torsteml/TFE4152-Project/report/TFE4152_project.pdf

Norges teknisk-naturvitenskapelige

universitet

TFE4152

# Design av 4 piksels digitalkamera

Skrevet av:
Markus Rud
Torstein Langan
20. november 2018

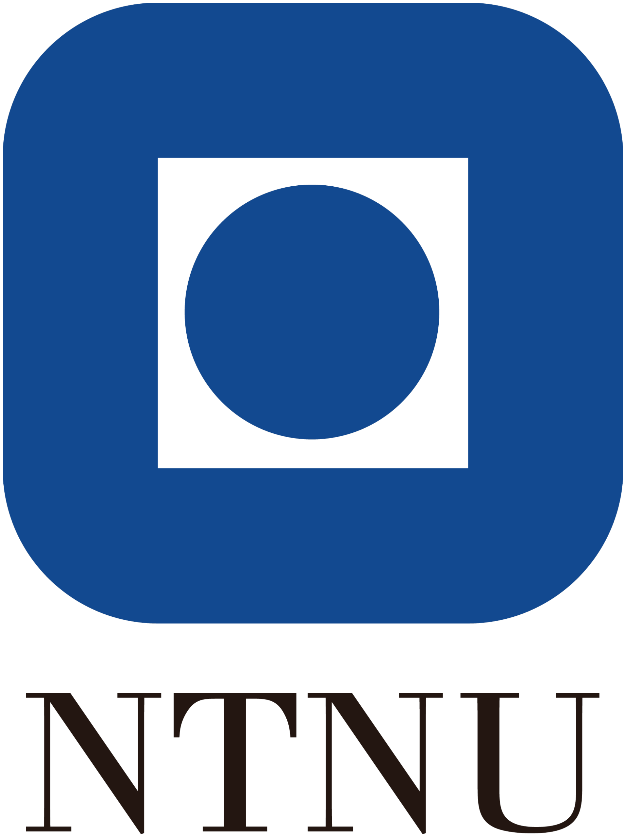
[picture p1: figure]

Sammendrag

En forenklet modell av et digitalkamera bestående av 4 piksler med tilhørende digital logikk og analog krets er blitt designet. Active-HDL og AIM-spice ble brukt til modellering, simulering og test for henholdsvis den digitale og analoge delen av systemet og ledet til en detaljert simulering av kritiske deler i et primitivt digitalkamera. Hver piksel ble bygget opp av NMOS og PMOS transistorer, som alle fungerte enten som brytere, aktive laster eller forsterkere, i tillegg til en fotodiode som registrerte pikselens påførte lysmengde under en gitt eksponeringstid. I tillegg ble det konstruert digital logikk for presis kontroll av pikslene. To tilstandsmaskiner og ett skiftregister holdt orden på eksponeringstid og sendte ut korrekte styringssignal til transistorbryterne i den analoge kretsen. Systemet oppfylte alle krav ved testing.

i

## Innhold

1 Introduksjon | 1
2 Teori | 1
3 Design | 10
4 Simulering og test | 15
5 Resultat og diskusjon | 19
6 Konklusjon | 22
Bibliografi | 23
A Digital kontrollogikk | 24

ii

B Analog krets | 30

iii

## 1 Introduksjon

Etter at digitalkameraet ble oppfunnet på tidlig 1970-tall har det revolusjonert hvordan vi mennesker deler informasjon med hverandre. Vi kunne ta mangfoldige tusen bilder om dagen, og dokumentere våre liv på ett detaljnivå vi tidligere ikke turte drømme om, samtidig som vi har enda finere kontroll over kamerainnstillingene enn før ved hjelp av microchiper og registre som styrer alle parametere med en utrolig nøyaktighet og presisjon. Som en del av kurset Design av integrerte kretser skal vi i dette notatet beskrive et mulig design for en primitiv version av et 4 piksels digitalkamera. Dette for å bedre forstå virkemåte og designhensyn som inngår i en slik prosess.

Det er designet en krets for et 4-piksels digtalkamera med mulighet for at brukeren kan justere eksponeringstiden ved påført signal på inngangene Exp increase og Exp decrease som vist i figur 1.1, før et bilde kan taes ved å påføre et signal på inngangen Init. Design av analog til digitalkonverteren ADC er ikke inkludert i dette notatet. Systemets utganger Out1 og Out2 settes til en digital verdi avhengig av mengden lys som treffer pikslene i den analoge kretsen.

Figur 1.1: Blokksjema av tenkt realisering.

## 2 Teori

Som vist i figur 1.1 er systemet bygget opp av tre mindre delsystemer der den digitale kontrollogikken og den analoge kretsen er presentert i denne rapporten. Da disse er designet svært individuelt vil resten av rapporten også behandle disse i stor grad adskilt.

### 2.1 Digital kontrollogikk

Første delsystem i kameraet er den digitale kontrollogikken. Et blokkskjema er vist i figur 2.1 og viser systemets inn og utganger. Systemet tar inn signalene Exp increase, Exp decrease og Init fra brukeren av kameraet mens reset-signalet Reset og klokka Clk kommer fra ytterligere kontrollogikk. Systemets 5 utganger kontrollerer ulike deler av den analoge kretsen hvor NRE R1 og NRE R2 kontrollerer når og hvilken piksel som skal avleses, ADC kontrollerer når ADCen skal initialiseres, Expose kontrollerer når kretsen skal eksponeres for lys og Erase nullstiller den analoge kretsen.

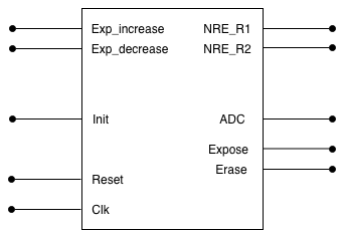
[picture p2: figure]

Figur 2.1: Blokkskjema av digitalt system for styring av analog krets.

Det digitale systemet er videre delt opp i tre mindre delsystemer som vist i figur 2.2. Av figuren kan man se at de nevnte delsystemene er CT RL ex time, T imer counter og F SM ex control. Disse er henholdsvis et register for eksponeringstid, en nedteller og FSM kontroll. Hver av disse vil bli forklart i påfølgende delkapitler.

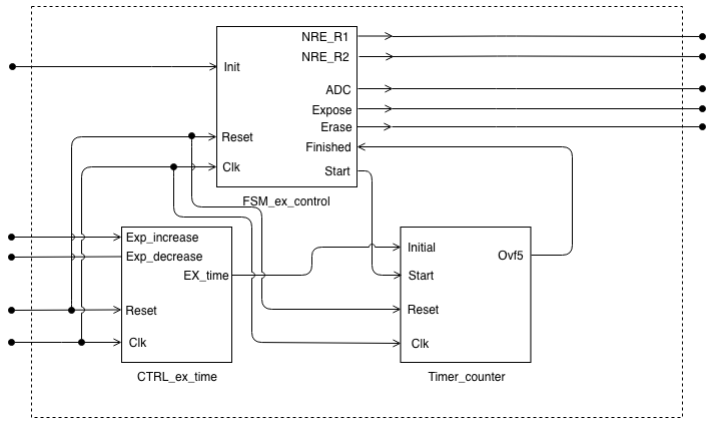
[picture p3: figure]

Figur 2.2: Blokkskjema for de ulike delsystemene i den digitale kontrollogikken.

### 2.1.1 Eksponeringstidregister

Når brukeren ønsker å ta et bilde er det nødvendig å vite hvor lenge pikslene skal eksponeres for lys da dette har mye å si for bildets kvalitet. Denne tiden kalles eksponeringstiden og ligger lagret i eksponeringstidregisteret. Systemet CT RL ex time på figur 2.2 er systemet som skriver tiden til registeret samt har nødvendig logikk for enten å øke eller senke eksponeringstiden. Dette kan gjøre på flere måter, men er her implementert ved bruk av et enkelt flerbits skiftregister som kan inkrementeres eller dekrementes ved bruk av signalene Exp increment og Exp decrement. Signalene er aktive høye, altså ved påtrykt Vdd. Ved høyt påtrykk på Exp increase skal systemet øke eksponeringstiden, mens ved høyt påtrykk på Exp decrease skal eksponeringstiden minke. Ved påtrykk på begge signalene samtidig er Exp increase satt til å ha prioritet.

### 2.1.2 Nedteller

Nedtelleren, T imer counter på figur 2.2, har som oppgave å telle ned eksponeringstiden avlest fra eksoponeringstidregisteret. Systemet skal starte nedtellingen ved høy verdi på Start og ved ferdig nedtelling settes utgangssignalet Ovf5 til høy verdi i en klokkesykel. Dette delsystemet er implementert som en tilstandsmaskin hvor tilstanden settes avhengig av delsystemene rundt. Nærmere design av denne er forklart i kapittel 3.1.2.

### 2.1.3 FSM kontroll

FSM kontroll, F SM ex control på figur 2.2, er kontrollenheten til hele systemet vist i blokkskjemaet i figur 1.1. FSM kontrollen mottar signalet Init fra brukeren og starter så en bildesekvens. Start-signalet starter telleren i T imer counter. Systemet er implementert som en tilstandsmaskin hvor tilstandene endres avhengig av input fra brukeren og T imer counter. Design av tilstandsmaskinen samt oversikt over ulike utgangssignaler i tilstandene er nærmere forklart i kapittel 3.1.3.

### 2.2 Analog pikselkrets

Den analog kretsen har som oppgave å detektere hvor mye lys som treffer et rutenett av piksler i løpet av en gitt eksponeringstid. Et slikt rutenettet kan bygges opp ved å sette flere enkeltpiksler sammen til en større krets slik at de individuelle pikselkretsene sammen kan danne et bilde.

### 2.2.1 Enkeltpiksel

Figur 2.3 viser hvordan en enkelt piksel kan bygges opp ved bruk av en fotodiode P D1 og flere MOSFET transistorer. På figuren er Vdd forsyningsspenningen og Vss er jordingsspenningen.

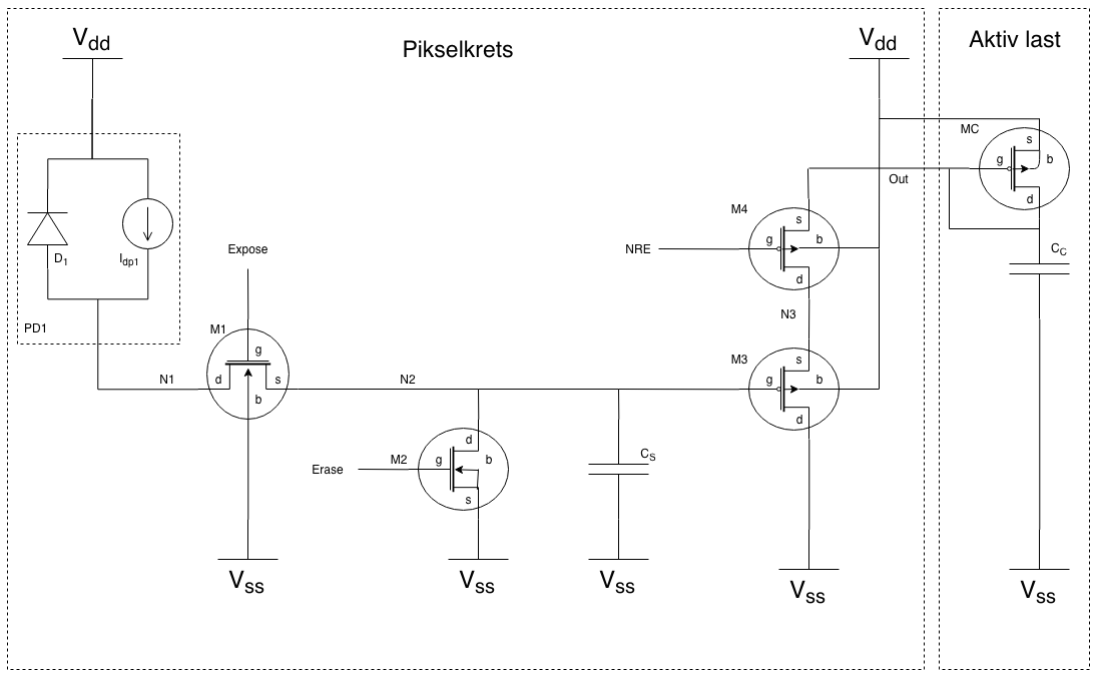
[picture p4: figure]

Figur 2.3: Analog krets for én piksel.

Fotodioden P D1 er her representert ved strømkilden Idp1 og pn-dioden D1 som vist i figuren. Ved lysinnstråling på P D1 øker den sin strømførende evne og det genereres en strøm til node N1. Når Expose-signalet settes høyt vil denne strømmen fortsette til node N2 gjennom transistoren M1 og dermed lade opp spenningen i kondensator CS. Når eksponeringen av bildet er ferdig settes Expose-signalet lavt og M1 lukkes. Den oppladede spenningen i CS forsterkes så gjennom transistoren M3 og blir tilgjengelig på utgangen Out når signalet NRE går lavt og åpner transistor M4. Når spenningen er avlest lukkes M4 og M2 åpnes ved å påføre spenning på Erase, dette setter spenningen på node N2 til Vss og kretsen er klar til å ta et nytt bilde.

Av figuren kan man også se det er en aktiv last bestående av transistoren MC og kondensatoren CC koblet til kretsen. Sammen med transistoren M3 skaper dette en buffer som holder spenningen på Out konstant lik spenningen over CS selv om verdien leses av.

### 2.2.2 Presentasjon av relevante transistorlikninger

Den analoge kretsens virkemåte er forklart i kapittel 2.2.1, men en annen viktig faktor for å oppnå riktig oppførsel er transistorenes størrelse. Transistorene i figur 2.3 har forskjellige virkemåter hvor transistorene M1, M2 og M4 benyttes som brytere, M3 benyttes som forsterker og MC benyttes som en aktiv last. Dimensjonene til de ulike transistorene avhenger av funksjonen og likninger for dette presenteres i senere delkapitler. Først i dette delkapitlet presenteres generelle transistorformler som videre brukes i mer spesifikke likninger og beregninger. Likningene som presenteres gjelder for NMOS-transistorer, men ved å invertere alle spenningene over transistorene kan samme likninger benyttes for NMOS-transistorer.

Generelle likninger for MOS transistorer
For en generell MOS transistor kan effektiv gate-source spenning uttrykkes på følgende måte [1, (1.50)]:

Vef f = Vgs − Vt

. | (2.1)

Transistorens terskelspenning Vt inkludert body effekt kan uttrykkes ved [1, (1.69)]:

Vt = Vt0 + γ(

p
VSB + |2φF | − p
|2φF |) | (2.2)

der γ er gitt av (2.10). Body effekt oppstår når source og body har forskjellig potensial, altså VSB 6= 0, og gjør at det blir vanskeligere for elektronene å bevege seg over pn-overgangen mellom drain og source. Denne effekten kan modelleres som en økt terskelspenning Vt som i (2.2). Vt0 er terskelspenningen ved null source-bulk spenning.

Bodyens Fermipotensial er gitt av følgende likning[1, s. 25]:

ΦF =

kT
q

ln NA
ni
| (2.3)

hvor k er Boltzmanns konstant, q er elementærladningen, NA er konsentrasjonen av mottaksatomer i silisium, ni er carrier konsentrasjonen til silisium og T er den absolutte temperaturen. Til slutt gir[1, (1.52)]

Cox =

Kox0

tox

(2.4)

gate kapasitansen (Cox), der Kox er den relative permittiviteten til silisium, 0 er permittiviteten til vakum og tox er tykkelsen på oksiden under gaten.

Likninger for MOS transistorer i aktivt område
For en MOSFET transistor i aktivt område uttrykkes drainstrømmen ID med følgende formel [1, (1.67)]:

ID =

µCox
2

W
L

(VGS − Vt)

2
[1 + λ(VDS − (VGS − Vt))] | (2.5)

der VGS er potensialforskjellen mellom gate og source, VDS er potensialforskjellen mellom drain og source og Vt er terskelspenningen til transistoren. W og L er hhv. bredde og lengde til transistoren og µ er mobiliteten til elektronene nære silikonoverflaten. λ er channel-length modulasjonsparameteren gitt av følgende likning [1, (1.87)]:

λ =

1
L

p
VDS − Vef f + Φ0
. | (2.6)

Short channel effekt er en bivirkning som oppstår når kanalen på undersiden av MOS-FETen blir mye tynnere enn utarmingssonen til drain og source. Det oppstår også short channel effekter ved VDS >> Vef f , og det er derfor viktig å begrense VDS for å minimere denne effekten. Φ0 er den innebygde spenningen til pn-overgangen i transistoren.

Videre er sammenhengen mellom motstanden fra drain til source og ID gitt av [1, (1.86)]

rds ≈

1
λID
. | (2.7)

Transkonduktansen til en MOSFET gitt ved [1, (1.77)]

gm =

r
2µCox

W
L
ID | (2.8)

mens den separate transkonduktansen til body effekten er [1, (1.83)]

gmb =

γgm
2

p
VSB + |2ΦF |

(2.9)

der γ kan uttrykkes ved [1, (1.70)]

γ =

√
2qNAKS0

Cox

. | (2.10)

Ks er her den relative permittiviteten til silisium. Legg merke til at selv om VSB = 0 i formel 2.9 ikke matematisk gir gmb = 0, vil en direkte kobling mellom bulk og source gjøre at body effekt transkonduktansen ekskluderes.

Likninger for en MOSFET i subterskel tilstand
Når VGS < Vt befinner transistoren seg i subterskel tilstand og spesielle tilfeller gjelder. Drainstrømmen uttrykkes ved [1, (1.121)]

ID = ID0

W
L

e

qVeff /nkT | (2.11)

som viser at ID ikke er null selv om VGS < Vt

. Videre kan n uttrykkes ved [1, (1.119)]

n =

Cox + Cj0

Cox

(2.12)

og drainstrømkonstanten, ID0, uttrykkes ved [1, (1.120)]

ID0 = (n − 1)µCox(

kT
q

)

2
. | (2.13)

### 2.2.3 Kondensatorstørrelser

Som nevnt i delkapittel 2.2.1 lades kondensatoren CS opp så lenge Expose har et høyt påtrykk. For at spenningen i kondensatoren skal være forutsigbar uavhengig av eksponeringstiden eller lysstyrken er det ønskelig at oppladningen av kondensatoren er lineær. Dette er mulig å oppnå ved å tilpasse kondensatorstørrelsen slik at den unngår metning. Spenningen over en kondensator er gitt ved

V =

1
C

Z T

0

i(t)dt | (2.14)

hvor V er spenningen over kondensatoren, C er kondensatorverdien, i(t) er strømmen gjennom kondensatoren og T er tiden kondensatoren blir ladet opp.

Ved beregning av størrelsen til kondensator CS er spenningen V gitt av spenningenspotensialet VN2 i node N2. Dette potensialet kan beregnes ut fra (2.1) med

Vgs = Vg − Vs = Vg − VN2 | (2.15)

hvor Vg er satt til Vdd ved høy påkjenning på Expose. Det er ønskelig at transistor M1 alltid opererer i sterk inversjon og av den grunn må Vef f være større enn 100mV[1,
s. 22]. Vt er gitt av (2.2) som også tar hensyn til transistorens body-effekt. Størrelsen på kondensator CC i den aktive lasten er gitt av spesifikasjonene.

### 2.2.4 Brytere

For at en transistor skal være i aktivt område må følgende betingelser oppfylles:

VGS > Vt | (2.16)
VDS > VGS − Vt | (2.17)

Det observeres at dette er tilfellet når både M1, M2 og M4 opereres, og dermed kan formel 2.5 og 2.7 benyttes.

Ved design av MOSFET-brytere er det to motstående fokusområder, spenningsfall over MOSFETen og hastigheten bryteren kan lukkes med. For transistor M1 og M4 er ikke hastigheten prioritert på grunn av systemets lave klokkefrekvens, men det ønskes heller et lavt spenningsfall for å minimere spenningsforskjellen mellom dioden P D1 og oppladningsspenningen til kondensatoren Cs. Fra formel 2.5 og 2.7 kan man se at motstanden rds får lavest verdi ved en høy strøm ID og det settes dermed en stor bredde W og en liten lengde L for at transistorene M1 og M4 skal ha en lav motstand rds og dermed lavt spenningsfall fra drain til source. Transistor M2 er koblet mellom node N2 og jordingsspenningen Vss og vil derfor utlade kondensator Cs om ikke lekasjestrømmen når transistoren er lukket er tilstrekkelig liten. Av formel 2.13 observeres det at for en liten ID, når transistoren er lukket, trengs en lav bredde W og stor lengde L.

Ved en lukket transistor M2 vil det likevel oppstå en liten lekasjestrøm til tross for at transistoren har blitt optimalisert med tanke på akkurat dette. For en lukket transistor gjelder Vgs < Vt og fra likningene 2.11, 2.12 og 2.13 kan lekasjestrømmen beregnes.

### 2.2.5 Source-følger

For at Cs ikke skal lades ut i det øyeblikket verdien utleses på utgangen, er det nødvendig med en buffer med så stor inngangsmotstand mellom Cs og utgangen som mulig. Bufferen kan realiseres som en source-følger med forsterkning tilnærmet lik 1, og transistorene M3 og MC tilpasses slik at bufferen oppfyller kravene. Kretsen i figur 2.3 forenkles ved å kortslutte alle bryterene, og det antas at spenningsfallet over disse er tilnærmet lik 0. I figuren nedenfor representerer Vin spenningen over kondensatoren Cs fra figur 2.3.

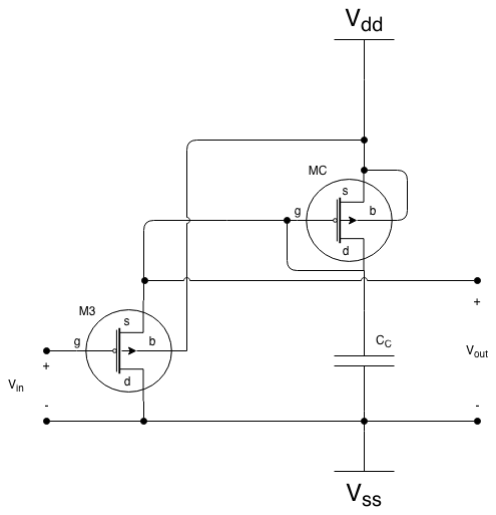
[picture p5: figure]

Figur 2.4: Transistor M3 og MC med kortsluttet transistor M4.

En småsignalekvivalent til transistor M3 er vist i figur 2.5. Vsg er spenningen mellom source og gate, Vsb er spenningen mellom source og bulk. rds3 er motstanden mellom drain og source og oppstår som følge av channel length modulasjon med modulasjonsparameter gitt av likning 2.6 og 2.7.

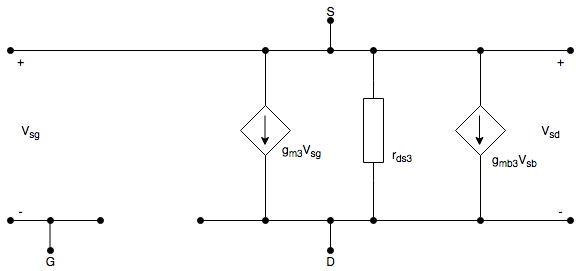
[picture p6: figure]

Figur 2.5: Småsignalekvivalent for transistoren M3.

Fordi bodyen ikke er koblet direkte til source i PMOS-transistoren M3, og det dermed oppstår en potensialforskjell mellom source og bulk (VSB 6= 0), er body effekten inkludert i utregningene. Body effekten er i figur 2.5 representert som strømkilden uttrykt ved gmb3Vsb. Ved å finne uttrykk for rds3, i tillegg til strømmene, kan det settes opp uttrykk for forholdet mellom Vout og Vin. Fra [1, (1.74)]

gm = µCox

W
L
(Vgs − Vt) | (2.18)

kan man se at transkonduktansen til transistoren er avhengig av både dimensjoner og transistorparameteren µCox i tillegg til spenningsforskjellen (Vgs − Vt).

Ulike spenningen i transistor M3 er definert som følger:

Vsg = Vout − Vin
Vsd = Vout. | (2.19)

Småsignalekvivalent til transistor MC presenteres i figur 2.6 og da bulken er koblet direkte til source er det ingen body effekt i transistoren, og derfor er det ingen potensialforskjell av formel 2.9 da VSB = 0.

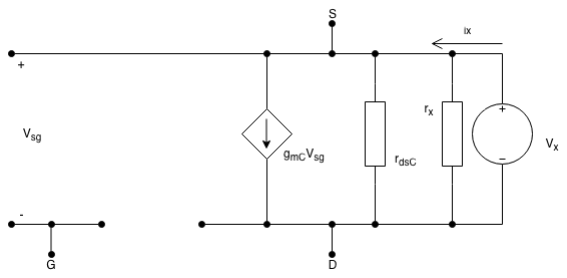
[picture p7: figure]

Figur 2.6: Småsignalekvivalent for den aktive lasten

Utgangsimpedansen til den aktive lasten er av interesse da denne er med på å definere virkemåten til source-følgeren i figur 2.4. Det påføres en testspenning Vx og en testimpedans rx på utgangen og Kirchhoff spenningslov(KVL) brukes for å definere verdien av utgangsimpedansen. Likningen

ix = gmCVsg +

Vx

rdsC

(2.20)

utledes fra KVL før det observeres at Vx = Vsg og likning 2.20 forenkles til

ix = Vx(gmC +

1

rdsC

)

Vx
ix

=

1

gmC +

1
rdsC

rx =

1

gmC +

1
rdsC
rx = RC.

(2.21)

Ved å sette sammen den aktive lasten og bufferen kan source-følgeren representeres med småsignalekvivalent som vist i figur 2.7.

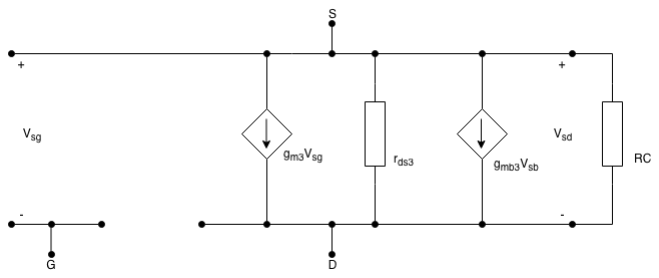
[picture p8: figure]

Figur 2.7: Småsignalekvivalent for source-følgeren med aktiv last inntegnet som impedans

Spenningsforsterkningen er gitt ved

Av =

Vout

Vin

. | (2.22)

Ved bruk av Kirchoffs strømlov og likning 2.19 settes opp likningssystemet

Vout

rds3

= gm3Vsg + gmb3Vsb +

Vout
RC

Vout

rds3

= gm3(Vout − Vin)gmb3Vout +

Vout
RC

Vout(

1

rds3

− gm3 − gmb3 −

1
RC

) = −gm3Vin.

| (2.23)

Innsatt i uttrykket for motstand RC fra likning 2.21 genereres følgende uttrykk for spenningsforsterkningen:

Av =

gm3

gm3 + gmC − gmb3 +

1
rdsC
. | (2.24)

Dette forenkles til
Av ≈

gm3

gm3 + gmC

(2.25)

når gmb3 ≈ 1/10gm3[1] og 1/rdsC ≈ 0[1] og derfor kan neglisjeres fra likning 2.24.

### 2.2.6 Rutenett av pikselkretser

For å designe en krets bestående av flere piksler er det mulig å koble sammen flere enkle pikselkretser til en større krets. En mulig oppkobling av dette er vist i figur 2.8 hvor en enkelt piksel er representert ved en boks bestående av enkeltkretsens inn og utgangssignaler. Signalene NRE R1 og NRE R2 avgjør hvilken piksel som skal leses av og signalet ADC avgjør når ADCene skal konvertere spenningen fra pikselene til en digital verdi. Resterende signaler fungerer som nevnt i delkapittel 2.2.1.

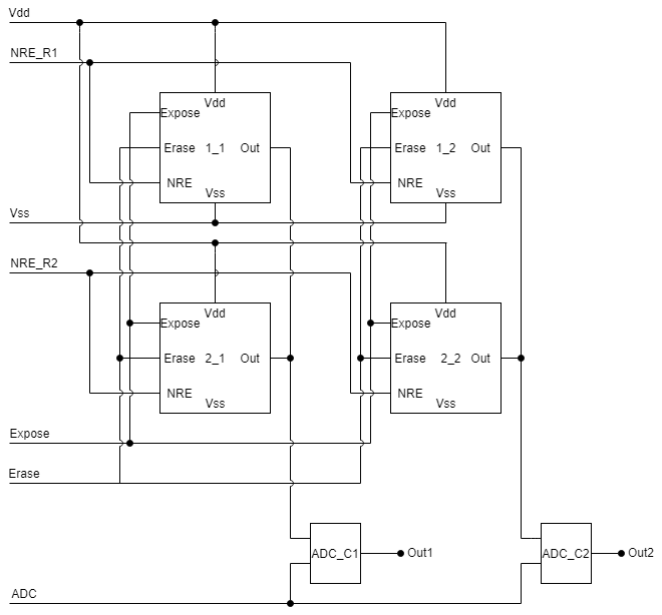
[picture p9: figure]

Figur 2.8: Sammensetning av fire analoge pikselkretser til et rutenett.

## 3 Design

### 3.1 Digital kontrollogikk

En simulering av den digitale kontrollogikken er designet med programmeringsspråket Verilog[2] og all kode er vedlagt i vedlegg A. Systemet er designet med hensyn på spesifikasjonene som vist i tabell 3.1.

Tabell 3.1: Kravspesifikasjoner til digital kontrollogikk
Spesifikasjon | Verdi
Maksimal eksponeringstid Minimal eksponeringstid Klokkefrekvens | 30 ms 2 ms 1 kHz

### 3.1.1 Eksponeringstidregister

Eksponeringstidregisteret er implementert som vist i figur 3.1 og består av et 5 bits skiftregister. Som nevnt i kapittel 2.1.1 er det tre måter å endre eksponeringstiden. Disse måtene er ved påtrykk på signalene Exp increase, Exp decrease eller Reset. Ved reset av registeret settes verdien til 2 ms. Tilhørende Verilogkode er vist i vedlegg A.1.

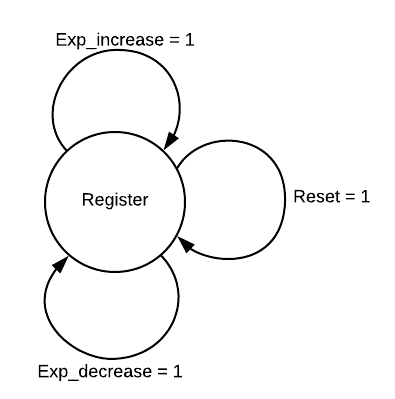
[picture p10: figure]

Figur 3.1: Eksponeringstidsregister med mulighet for endring av eksponeringstid

### 3.1.2 Nedteller

Nedtelleren er implementert som en tilstandsmaskin bestående to tilstander som vist i figur 3.2. Tilstanden Base er en grunntilstand hvor systemet venter på høyt Start-signal fra F SM kontroll, dette er også tilstanden systemet settes til ved en reset. Ved mottatt høyt Start-signal endres tilstanden til Nedtelling. Dette er en tilstand hvor tiden fra eksponeringstidsregisteret i figur 3.1 leses av og telles ned. Ved ferdig nedtelling settes signalet Ovf5 høyt og systemet returnerer til grunntilstanden. Systemet returnerer også til grunntilstanden ved påføring av et høyt Reset-signal, men Ovf5 forblir da lav.

Systemets Verilogkode er vist i vedlegg A.2 og viser den fysiske implementeringen av tilstandsmaskinen. Som vist i linje 20 i vedlegget er det benyttet en case for å realisere tilstandsmaskinen. Innad i hver tilstand utføres det en test om tilstanden skal endres og ut fra dette har systemet kontroll på om det skal sendes ut et signal eller ikke.

Figur 3.2: Tilstander i nedtelleren T imer counter

### 3.1.3 FSM kontroll

FSM kontrollen er som nevnt implementert som er tilstandsmaskin og består av tilstandene som vist i figur 3.3. Tilstanden V entende er en grunntilstand hvor systemet venter til den mottar en puls på Init. Ved mottatt puls på Init settes tilstanden til Eksponering og kameraet er i eksponeringsmodus frem til nedtelleren T imer counter har telt ned. Når eksponeringen er ferdig endres tilstanden til U tlesning og en utlesningssekvens begynner. Sekvensen avsluttes med at systemet returnerer til tilstanden V entende og venter på at neste bilde skal tas. Utgangssignalene i de ulike tilstandene er som vist i figur 3.4. Ved en reset av systemet avbrytes alle prosesser og tilstanden settes til grunntilstanden V entende.

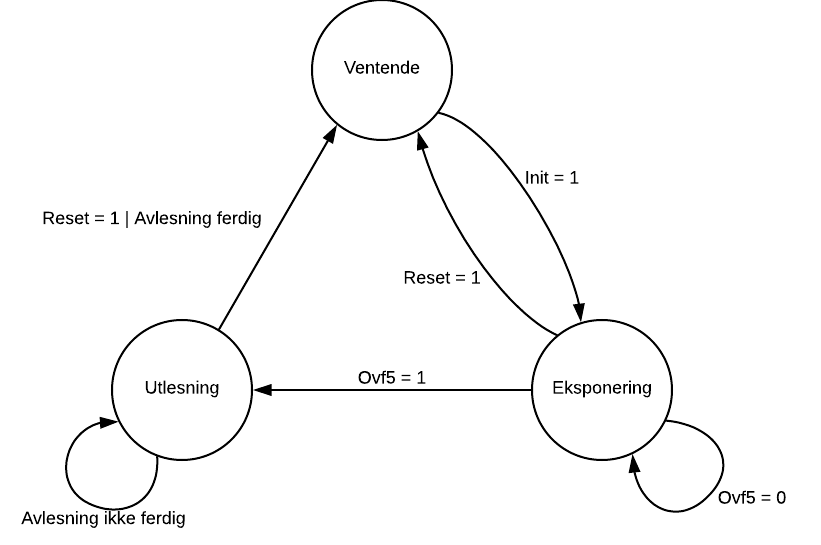
[picture p11: figure]

Figur 3.3: Tilstander i F SM ex control

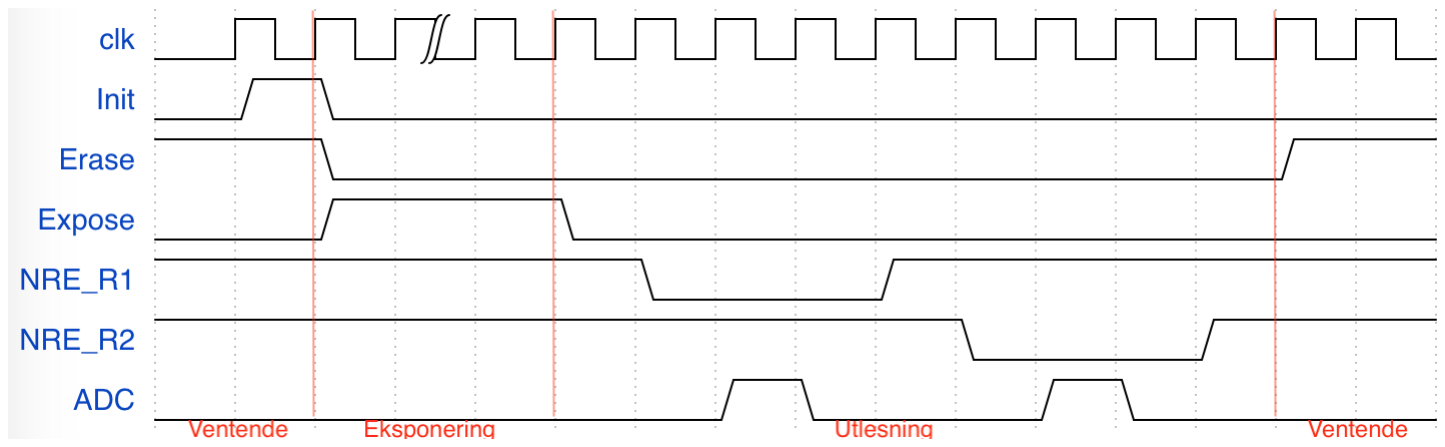
[picture p12: figure]

Figur 3.4: Utgangssignalene i de ulike tilstandene.

Systemets Verilogkode er vist i vedlegg A.3. Som vist i vedlegget linje 25 er tilstandsmaskinen realisert ved bruk av en case hvor tilstanden endres avhengig av ulike inputs. Utlesningssekvensen i tilstanden U tlesning er også realisert ved bruk av en case som kontinuerlig hopper videre gjennom prosessen og tilslutt returnerer til grunntilstanden.

### 3.1.4 Sammensatt krets

De ulike delsystemene er tilslutt koblet sammen til en sammensatt krets som vist i figur 2.2. Verilogkode er vist i vedlegg A.4.

### 3.2 Analog krets

De tilhørende kravspesifikasjonene[3, s. 10] som vist i tabell 3.2 setter rammene for det analoge systemet. Transistorparameterene for 180 nm transistorteknologi er vist i tabell 3.3.

Tabell 3.2: Tilhørende kravspesifikasjoner for pikselkretsen i figur 2.3.
Spesifikasjon | Verdi
Maksimal transistorbredde, Wmaks Minimal transistorbredde, Wmin Maksimal transistorlengde, Lmaks Minimal transistorlengde, Lmin Maksimal kondensatorstørrelse Maksimal strøm fra P D1 Minimal strøm fra P D1 | 10 µm 2 µm 2 µm 0.7 µm 3 pF 750 pA 50 pA

Tabell 3.3: Transistorparametere for 180 nm teknologi[1, tabell 1.5].
Parameter | Verdi | Enhet
- | NMOS | PMOS | -
µCox Vt0 λ · L Cox tox n θ m | 270 0.45 0.08 8.5 5 1.6 1.7 1.6 | 70 -0.45 0.08 8.5 5 1.7 1.0 2.4 | µA/V² V µm/V fF/µm² nm -1/V -

### 3.2.1 Kondensatorstørrelser

Ut fra spesifikasjonene er det to grensetilfeller størrelsen på kondensator CS er tilpasset. Det første tilfellet er maksimal strøm fra P D1 på 750 pA og minimal eksponeringstid på 2 ms og det andre tilfellet er minimal strøm på 50 pA og maksimal eksponeringstid på 30 ms. Innsatt i likning 2.14 gir begge grensetilfellene likningen

V =

1, 5 · 10⁻¹²
C
. | (3.1)

Som nevnt i kapittel 2.2.3 er spenningen V lik spenningen VN2 og ut fra beregninger med parametrene i tabell 3.3 og Vef f satt til 200 mV gir dette spenningen VN2 =1.16
V. Innsatt i likning 3.1 gir dette størrelsen CS=1.3 pF. Kondensatoren CC er som nevnt gitt av spesifikasjonene[3, s. 10] og er satt til 3 pF.

### 3.2.2 Brytere

Som forklart i kapittel 2.2.4 ønskes det at transistorbryterene M1 og M4 skal ha stor bredde W og liten lengde L for å minimere spenningsfallet og størrelsene settes derfor til

W1 = W4 = 10µm
L1 = L4 = 0.7µm

(3.2)

i henhold til ekstremalverdiene oppgitt i tabell 3.2. Tilsvarende ønskes det for transitorbryter M2 at bredden W er liten og lengden L er stor for å minimere lekasjestrømmen. Størrelsene settes derfor til

W2 = 2µm
L2 = 2µm

(3.3)

også i henhold til ekstremalverdiene oppgitt i tabell 3.2. For å verifisere at lekasjestrømmen ligger innenfor et akseptabelt nivå når transistor M2 er lukket benyttes likningene 2.11, 2.12 og 2.13. Det observeres fra figur 2.3 at de ulike transistorbryterene alltid vil ha Vs = 0 i lukket tilstand og ved bruk av n fra tabell 3.3 og temperaturen T = 300 K kan lekasjestrømmen beregnes til å være tilnærmet lik 0 fra likning 2.11

### 3.2.3 Source-følger

I kapittel 2.2.5 ble det funnet et uttrykk for spenningsforsterkningen Av som vist i likning 2.25. For å oppnå en spenningsforsterkning på Av = 1 er det nødvendig at gm3 >> gmC og ved å studere formel 2.8 er det gitt at

W3
L3

>>

WC
LC
. | (3.4)

Transistorstørrelsene settes derfor til W3 = 10 µm, L3 = 0.7 µm, WC = 2 µm og LC = 2 µm i henhold til ekstremalverdiene i tabell 3.2.

### 3.2.4 Endelige komponentstørrelser

Tabell 3.4 viser en samlet oversikt over størrelsene til de ulike transistorene.

Tabell 3.4: Endelige transistorstørrelser.
Transistor | Størrelse
M1 | W1 = 10 µm
L1 = 0.7 µm

M2

W2 = 2 µm
L2 = 2 µm

M3

W3 = 10 µm
L3 = 0.7 µm

M4

W4 = 10 µm
L4 = 0.7 µm
MC WC = 2 µm LC = 2 µm

Tabell 3.5 viser en samlet oversikt over kondensatorstørrelsene.

Tabell 3.5: Endelige kondensatorstørrelser
Kondensator | Verdi
Cs | 1.3 pF
CC | 3.0 pF

## 4 Simulering og test

Den analoge kretsen og den digitale kretsen er testet hver for seg. Dette er gjort da det ikke er en direkte måte å koble de ulike simuleringene sammen på, men signalene ut fra den digitale delen er brukt ved testing av den analoge delen.

### 4.1 Digital krets

Den digitale kretsen er simulert ved å påføre ulike signaler på inngangene til kretsen og ut ifra det se hvilke signaler som oppstår på utgangen. Hvert delsystem er testet hver for seg før de er satt sammen og hele den digitale kretsen er testet sammen.

### 4.1.1 Eksponeringstidregister

CTRL ex time-blokken er testet ved først å initialisere blokken påføring av et høyt Reset-signal og deretter teste Exp increase og Exp decrease samt hvem av dem som har prioritet. Resultatet av dette er vist i figur 4.1. Slik man kan se av figuren øker EXtime mens Exp increase er høy og minkes ikke under 2ms når Exp decrease er høy slik som spesifikasjonene tilsier. Simuleringen viser også at når begge inngangssignalene er høye, er det Exp increase som har prioritet. Som vist i figuren ved 65ms er også Reset-signalet testet og verdien på EXtime til 2 ms.

Da spesifikasjonene til systemet sier at eksponeringstiden skal være mellom 2 og 30 ms er systemet også testet for maks eksponeringstid. Dette er vist i figur 4.2 og viser at makstiden det er mulig å oppnå er 1E16 ms som tilsvarer 30 ms i desimaltall.

Figur 4.1: Simulering av økt og senket eksponeringstid samt reset-funksjonen i eksponeringstidregisteret CT RL ex time

Figur 4.2: Simulering av maksimal eksponeringstid i eksponeringstidregisteret CT RL ex time

### 4.1.2 Nedteller

Nedtelleren T imer counter er testet ved å påføre en gitt tid på inngangen Initial og derfra se om det tar like lang tid før utgangen Ovf5 settes til høy. Resultatet er vist i figur 4.3 og viser at når systemet har tiden 5 på Initial, tar det 5 klokkesykler fra Start settes til høy til Ovf5 går høy.

Figur 4.3: Simulering av nedtelling fra tiden 5 i nedtelleren T imer counter

Det er også testet at reset-funksjonen fungerer som ønsket. Resultatet av dette er vist i figur 4.4 og slik man kan se i motsetning til tidsdiagrammet i figur 4.3 går ikke Ovf5 høy etter at Reset har vært høy.

Figur 4.4: Simulering av reset-funksjonen i nedtelleren T imer counter

### 4.1.3 FSM kontroll

F SM ex control er testet ved først å initialisere verdiene ved påføring av et høyt Reset-signal for deretter å sette Init til høy i en klokkesykel. Da modulen enda ikke er tilkoblet til T imer counter, ble Ovf5 manuelt satt høy etter en viss tid. Resultatet er vist i figur 4.5.

Det er også testet om reset-funksjonen fungerer som ønsket. Resultatet av dette er vist i figur 4.6 og viser at prosessen stopper og alle verdier settes til startverdiene.

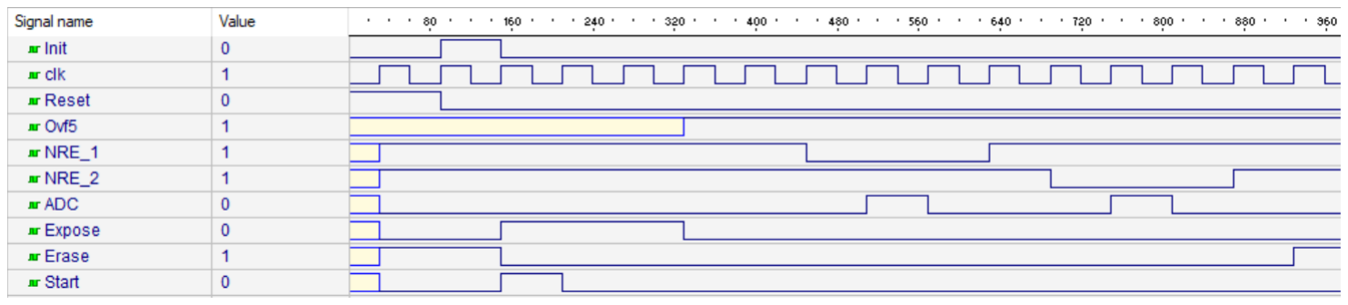
[picture p13: figure]

Figur 4.5: Simulering av FSM kontrollen F SM ex control

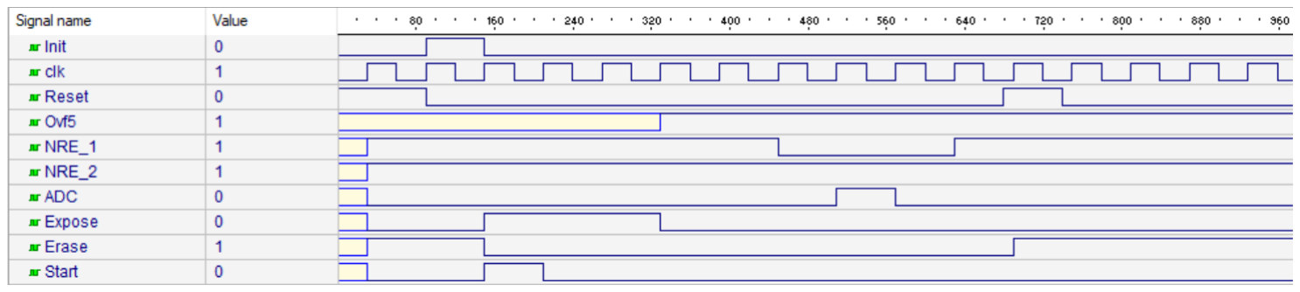
[picture p14: figure]

Figur 4.6: Simulering av reset-funksjonen til FSM kontrollen F SM ex control

### 4.1.4 Sammensatt krets

Tilslutt er hele den digitale delen testet ved først å initialisere verdiene ved bruk av signalet Reset, etterfulgt av endring i Exp increase og Exp decrease samt tilslutt settes Init høy for å ta bilde. Resultatet er vist i figur 4.7.

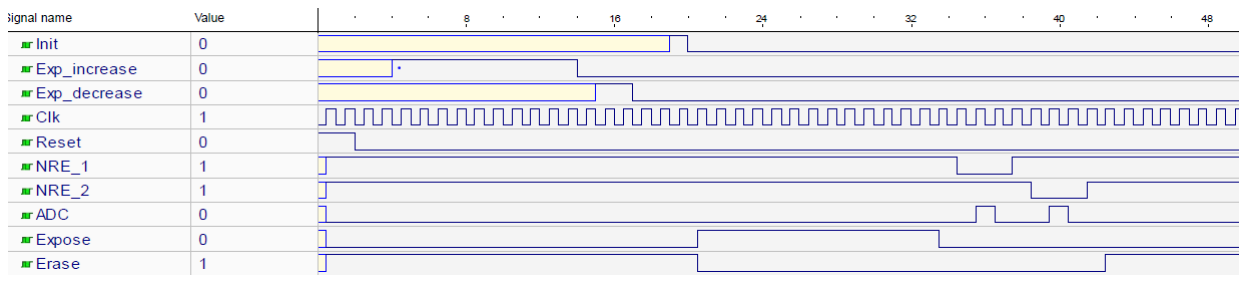
[picture p15: figure]

Figur 4.7: Simulering av det sammensatte digitale systemet

Reset-funksjonen er også testet for det sammensatte digitale systemet og resultatet er vist i figur 4.8 viser at det fungerer som ønsket.

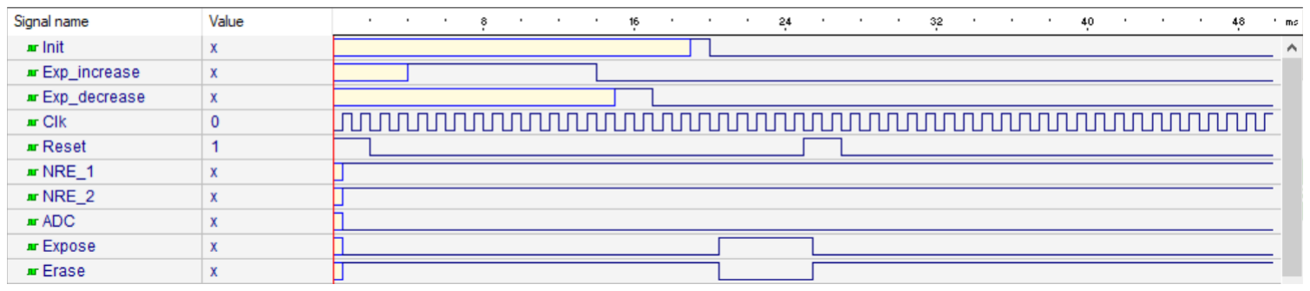
[picture p16: figure]

Figur 4.8: Simulering av reset-funksjon for det sammensatte digitale systemet

### 4.2 Analog krets

Den analoge kretsen fra figur 2.3 simuleres i AIM-Spice[4] med kode som vist i vedlegg B.1. Benyttede transistor og kondesatorstørrelser er som vist i tabell 3.4 og 3.5. Figur 4.9 og 4.10 viser resultatet ved simulering av en enkelt piksel ved de to grensetilfellene som nevnt i kapittel 3.2.1.

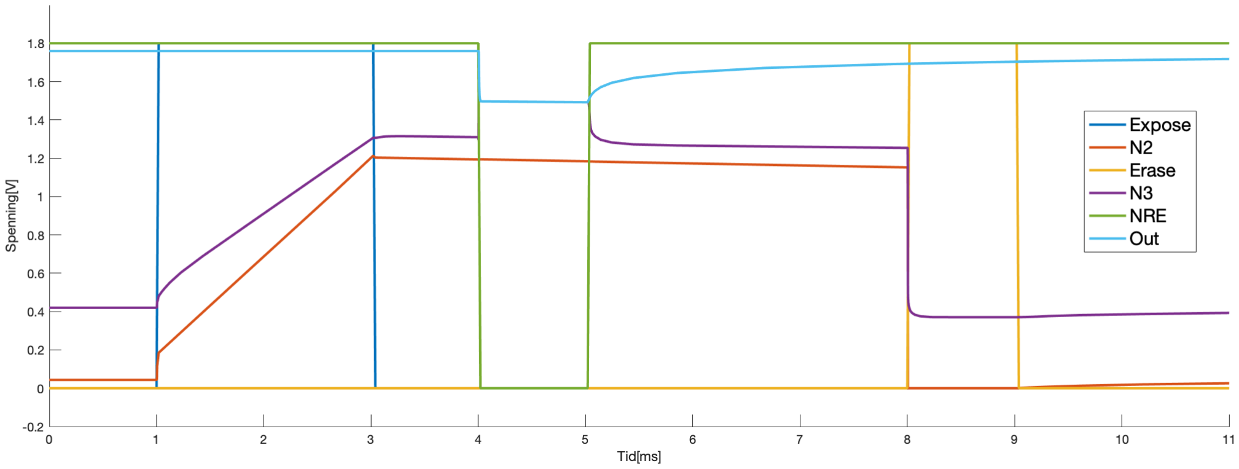
[picture p17: figure]

Figur 4.9: Simulering av individuell pikselkrets med Cs =1.3 pF med eksponeringstid 2 ms og fotodiodestrøm lik 750 pA. Resultater fra AIM-Spice, og plottet i MATLAB[5]

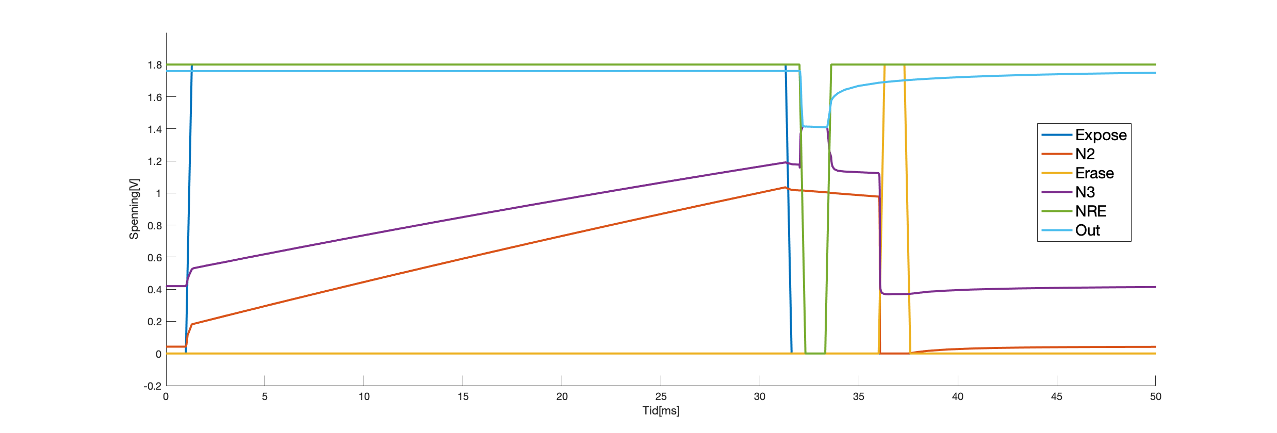
[picture p18: figure]

Figur 4.10: Simulering av individuell pikselkrets med Cs =1.3 pF med eksponeringstid 30 ms og fotodiodestrøm lik 50 pA. Resultater fra AIM-Spice, og plottet i MATLAB

Av figurene kan man se at spenningen over kondensatoren, spenningen i node N2, er lineær i begge tilfellene, men at spenningen faller litt etter at eksponeringen er ferdig. Figurene viser også at ved avlesning stabiliserer spenningen på Out seg mellom spenningene VDD og VN2. Av figuren kan man også se at når Erase går høy faller spenningen VN2 til 0 V.

Fire enkeltpiksler er satt sammen til et rutenett som vist i figur 2.8. Resultatene ved bruk at testbenken i vedlegg B.2 er vist i figur 4.11 og 4.12 for strømmer på henholdsvis 750 pF og 50 pF.

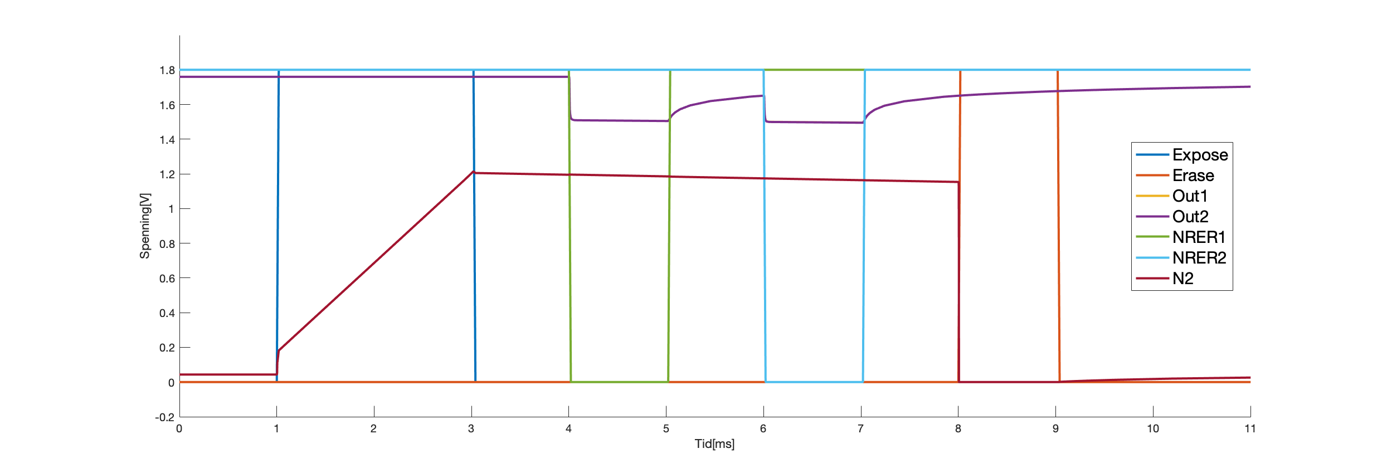
[picture p19: figure]

Figur 4.11: Simulering av rutenett av pikselkrets med Cs =1.3 pF med eksponeringstid 2 ms og fotodiodestrøm lik 750 pA. Resultater fra AIM-Spice, og plottet i MATLAB

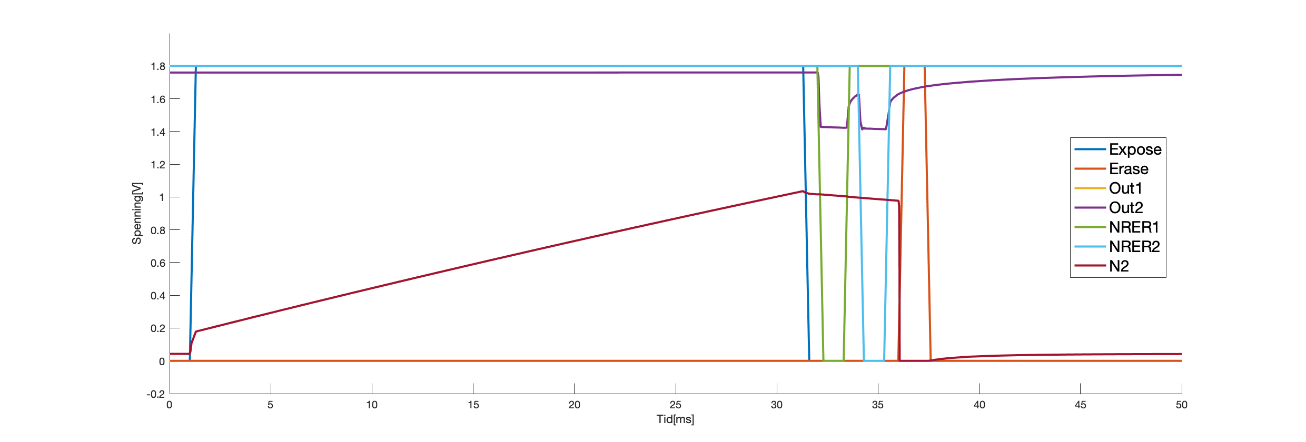
[picture p20: figure]

Figur 4.12: Simulering av rutenett av pikselkrets med Cs =1.3 pF med eksponeringstid 30 ms og fotodiodestrøm lik 50 pA. Resultater fra AIM-Spice, og plottet i MATLAB

Av figuren kan man se at man får en utslag på Out ved to tilfeller. Først er det en avlesning når NRE R1 er lav og derretter når NRE R2 er lav. Out-signalet er heller ikke blir påvirket av endringer i Expose eller Erase. Fordi benyttet testbenk påfører samme strøm til alle pikselene, får alle pikslene samme utslag og spenningen på Out1 og Out2 er derfor identiske.

## 5 Resultat og diskusjon

### 5.1 Digital kontrollogikk

Resultatene presentert i kapittel 4.1 viser at systemet fungerer som ønsket. Simuleringene i figur 4.1 og 4.2 viser at eksponeringstiden holder seg innenfor de gitte spesifikasjonene på 2 ms og 30 ms samt at ved en reset av eksponeringstidssregisteret settes tiden til 2 ms slik som valgt i designet.

Figur 4.3 viser at nedtellingssystemet fungerer som ønsket ved at det tar like mange klokkesykler fra Start går høy som verdien på Init før Ovf5 går høy. På figuren er det vist et eksempel med verdien 5 på Initial og systemet venter 5 klokkesykler før Ovf5 går høy. Av figur 4.4 kan man se at reset-funksjonen også fungerer som ønsker ved at Ovf5 forblir lav.

Det er ønskelig at utgangssignalene fra FSM kontrollen er som vist i figur 3.4 og av resultatene vist i figur 4.5 kan man se at dette stemmer. Systemet starter eksponeringen en sykel etter at Init går høy og fortsetter frem til Ovf5 går høy. Derretter starter den automatsike utlesningssekvensen og fortsetter akkurat som ønsket. I figur 4.6 kan man se at reset-funksjonen avbryter utlesningssekvensen og setter alle verdier til grunntilstandsverdiene.

Figur 4.7 viser at den sammensatte digitale kontrollogikken fungerer som ønsket. Det er mulig å endre eksponeringstiden og resten av bildesekvensen fungerer i henhold til ønsket virkemåte. Figur 4.8 viser at ved en reset av hele det digitale systemet settes utgangssignalene til riktige verdier og kretsen blir resatt på en riktig måte.

### 5.2 Analog krets

Resultatene presentert i kapittel 4.2 viser at både den analoge individuelle pikselkretsen og det sammensatte rutenettet av analoge pikselkretser i all hovedsak fungerer som forventet. Det finnes derimot noen få abnormaliteter som vil bli diskutert i det følgende underkapittelet.

Den individuelle pikselkretsen fra 2.3 responderer som ventet når den utsettes for stimuli fra testbenken definert i vedlegg B.2. Det observeres at kondensator Cs lades opp ved eksponering og verdien leses av ved lav verdi på signalet NRE. Videre sees det at kondensatoren Cs lades ut ved høy verdi på signalet Erase og pikselkretsen settes tilbake til utgangstilstanden.

Det observeres fra figur 4.9 og 4.10 at spenningen over node N2 ikke holdes konstant fra signalet Expose går lavt til signalet Erase går høyt. Dette skyldes i all hovedsak en lekasjestrøm i transistorbryteren M2 som gjør at ladningen i kondensatoren Cs gradvis lekker til Vss mens avlesningen av spenningsverdien pågår. Dette er ikke heldig, da det risikeres at ADCen registrerer forskjellige spenning på piksler som er eksponert samtidig, men avleses til ulikt tidspunkt. Figur 5.1 viser et utsnitt av plottet fra figur 4.9 og viser forskjellen i spenning.

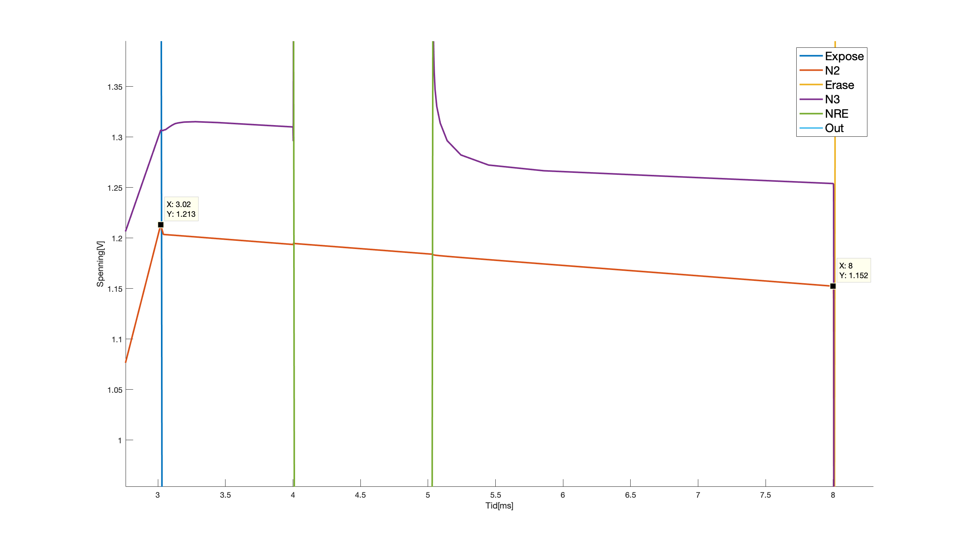
[picture p21: figure]

Figur 5.1: Utsnitt av figur 4.9 med fokus på området fra Expose går lav til Erase går høy. Høyeste og laveste spenningsverdi i det gjeldende området er markert.

Strømmen over node N2 vil være den samme for alle 4 pikslene i rutenettet på grunn av testbenken slik at det er tilstrekkelig å studere kun den ene. Det totale spenningstapet under avlesning finnes til 0.061 V, noe som tilsvarer et prosentvis tap på

0.061
1.213
- 100% = 5.03% | (5.1)

ved en 5 ms avlesningsperiode.

En annen faktor ved resultatene er spenningen i node N2 når signalet Expose går høyt. Et utsnitt av spenningen fra figur 4.9 er vist i figur 5.2.

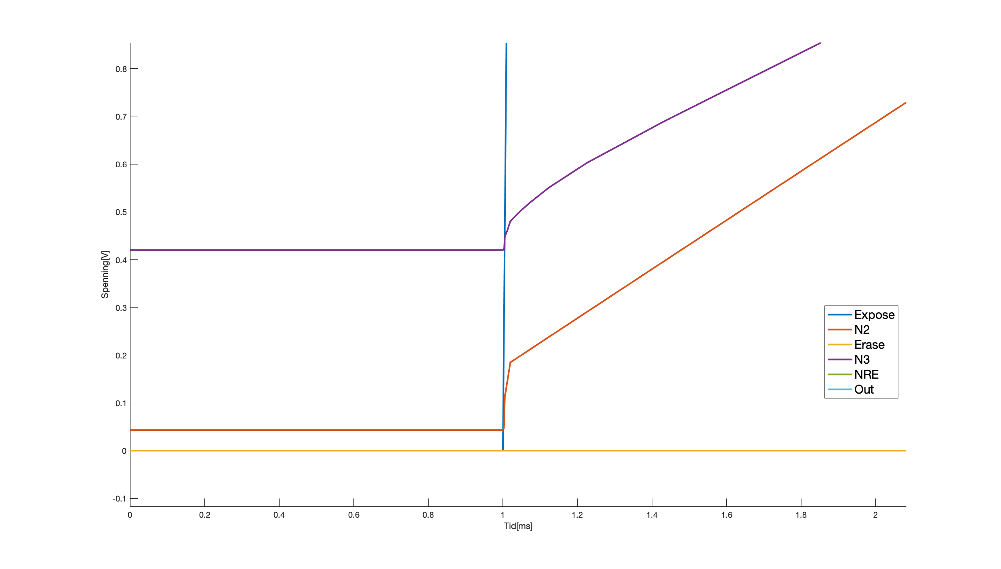
[picture p22: figure]

Figur 5.2: Utsnitt av 4.9 med fokus på tilfellet der Expose går fra lav til høy.

Når Expose er lav vil transistorbryter M1 lede i subterskel tilstand. Dette vil i praksis si at det går en liten strøm gjennom transistor M1 selv når den er lukket. Når Expose så blir høy, og transistor M1 plutselig begynner å lede, vil kondensator Cs plutselig se en ny krets koblet til seg. Impedansen har altså gått fra å være veldig stor til å bli veldig liten. Ettersom systemets tilstand endres drastisk, er det rimelig å anta at DC-nivået i disse tilstandene også vil være forskjellige. Som en tilleggsopplysning kan den nevnes at transistor M1 ikke vil begynne å lede helt umiddelbart, men ettersom klokkehastigheten er 1 kHz vil det oppleves temmelig momentant da transistoren åpnes i løpet av nanosekunder.

Det observeres til slutt at spenningsverdien mellom node N2 og node N3 ligger med en stadig minkende avstand mellom hverandre fra figur 4.9 etterhvert som spenningen på hver av nodene øker. I starten når NRE er høy, og transistor M4 ikke leder, er DC-nivået kun på grunn av body effekten i transistoren. Etterhvert som spenningen stiger, og potensialet på gaten til transistor M3 øker, blir avstanden mindre fordi source og bulk potensialet blir mindre, og body effekten blir mindre virkningsfull.

## 6 Konklusjon

Digitalkameraet er realisert som et rutenett av analoge pikselkretser med tilhørende digital kontrollogikk. Den analoge kretsen ble designet ved hjelp av transistorbrytere, en forsterker og en aktiv last, og alle ble dimensjonert for å fungere godt med hverandre. I tillegg ble body effekt og short channel effekt tatt høyde for slik at den realiserte kretsen fungerte så nært utregningene som mulig ved simulering. Den analoge kretsen responderte i henholdt til gitte krav som diskutert i kapittel 5.2.

Kameraets digitale kontrollogikk er designet som ulike tilstandsmaskiner og et skiftregister. Systemet holder seg innenfor de gitte kravene på minste eksponeringstid på 2 ms og maksimale eksponeringstid på 30 ms.

## Bibliografi

[1] Tony Chan Carusone, David Johns, and Kenneth Martin. ANALOG INTEGRA-TED CIRCUIT DESIGN International student version. John Wiley & Sons, Inc, 2013.
[2] Fakta om verilog. https://en.wikipedia.org/wiki/Verilog.
[3] Bjørn B. Larsen. TFE4152 – Design of integrated circuits 2018, Project description, Digital camera. 2018.
[4] Aim-spice hjemmeside. http://www.aimspice.com/.
[5] Matlab hjemmeside. https://www.mathworks.com/products/matlab.html.

## A Digital kontrollogikk

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

9
10 | a l w a y s f f @( p o sed ge cl k ) be gin
11 | i f ( Rese t ) EXtime = 2 ;
12 | e l s e i f ( E x p i n c r e a s e ) be gin
13 | i f ( EXtime < 3 0 ) EXtime <= EXtime + 1 ;
14 | end
15 | e l s e i f ( E x p d e c r e a s e ) be gin
16 | i f ( EXtime > 2 ) EXtime <= EXtime − 1 ;
17 | end
18 | end
19 | endmodule

A.2 | Nedteller
1 | ‘ t i m e s c a l e 1 ms / 1 ns
2 | module Time r c oun te r ( Re se t , cl k , S t a r t , I n i t i a l , Ovf5 ) ;

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

19
20 | c a s e ( s t a t e )
21 | S0 : be gin
22 | Ovf5 = 0 ;
23 | i f ( S t a r t ) n e x t S t a t e = S1 ;
24 | e l s e n e x t S t a t e = S0 ;
25 | end
26 | S1 : be gin
27 | i f ( c o u n t e r == I n i t i a l −1) be gin
28 | Ovf5 = 1 ;
29 | n e x t S t a t e = S0 ;
30 | end
31 | e l s e c o u n t e r = c o u n t e r + 1 ;
32 | end
33 | endc a se
34 | end
35 | endmodule

A.3 | FSM kontrol
1 | ‘ t i m e s c a l e 1 ms / 1 ns
2 | module FSM ex c on t r ol ( Re se t , Clk , E rase , Expose ,ADC ,NRE 1 ,NRE 2 , I n i t
, S t a r t , Ovf5 ) ;

3
4 | output r e g E rase ;
5 | output l o g i c Expose , ADC, NRE 1 , NRE 2 , S t a r t ;
6 | inp u t wi r e Reset , Clk , I ni t , Ovf5 ;
7 | r e g [ 3 : 0 ] c o u n t e r ;
8 | r e g S t a r t e d ;
9 | i n i t i a l be gin
10 | c o u n t e r = 0 ;
11 | S t a r t e d = 0 ;
12 | end

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

20
21 | c a s e ( s t a t e )
22 | S0 : be gin
23 | Expose = 0 ; NRE 1 = 1 ; NRE 2 = 1 ; ADC = 0 ; S t a r t = 0 ; E rase = 1 ;
S t a r t e d = 0 ;
24 | i f ( I n i t )
25 | n e x t S t a t e = S1 ;
26 | e l s e
27 | n e x t S t a t e = S0 ;
28 | end

29
30 | S1 : be gin
31 | i f ( ! S t a r t e d ) be gin
32 | S t a r t = 1 ; Expose = 1 ; E rase = 0 ;
33 | S t a r t e d = 1 ;
34 | end
35 | e l s e S t a r t = 0 ;
36 | i f ( Ovf5 ) be gin
37 | n e x t S t a t e = S2 ;
38 | Expose = 0 ;
39 | end
40 | e l s e be gin
41 | n e x t S t a t e = S1 ;
42 | end
43 | end

44
45 | S2 : be gin
46 | c a s e ( c o u n t e r )
47 | 1 : NRE 1 = 0 ;
48 | 2 : ADC = 1 ;
49 | 3 : ADC = 0 ;
50 | 4 : NRE 1 = 1 ;
51 | 5 : NRE 2 = 0 ;
52 | 6 : ADC = 1 ;
53 | 7 : ADC = 0 ;
54 | 8 : be gi n
55 | NRE 2 = 1 ;

56 | n e x t S t a t e = S0 ;
57 | end
58 | endc a se
59 | c o u n t e r = c o u n t e r + 1 ;
60 | end
61 | endc a se
62 | end
63 | endmodule

A.4 | Sammensatt krets
1 | ‘ t i m e s c a l e 1 ms / 1 us
2 | module RE c on t r ol ( I ni t , E x p i n c r e a s e , Exp dec re a se , Clk , Reset , NRE 1 ,
NRE 2 , ADC, Expose , E rase ) ;

3
4 | inp u t l o g i c I ni t , E x p i n c r e a s e , Exp dec re a se , Clk , Rese t ;
5 | output l o g i c NRE 1 , NRE 2 , ADC, Expose , E rase ;
6 | wi r e [ 4 : 0 ] EXtime ;
7 | l o g i c S t a r t , Ovf5 ;

8
9 | CTRL ex time timeBlock ( E x p i n c r e a s e , E x p d e c r e a s e , Clk , Rese t , EXtime ) ;
10 | Time r c oun te r c o u n t e rBl o c k ( Rese t , Clk , S t a r t , EXtime , Ovf5 ) ;
11 | FSM ex c on t r ol s t a t e Bl o c k ( Rese t , Clk , E rase , Expose ,ADC ,NRE 1 ,NRE 2 ,
I n i t , S t a r t , Ovf5 ) ;
12 endmodule

A.5 | Testbenk sammensatt krets
1 | ‘ t i m e s c a l e 1 ms / 1 us

2
3 module RE control TB ;

4
5 l o g i c I ni t , E x p i n c r e a s e , Exp dec re a se , Clk , Reset , NRE 1 , NRE 2 , ADC, Expose , Erase , Ovf5 ;

6
7 RE c on t r ol c o n t r o l u n i t ( I ni t , E x p i n c r e a s e , Exp dec re a se , Clk , Reset , NRE 1 , NRE 2 , ADC, Expose , Erase , Ovf5 ) ;

8
9 | i n i t i a l be gin
10 | Clk=0; Rese t = 1 ; #2;
11 | Rese t = 0 ; #2;
12 | E x p i n c r e a s e = 1 ; #10;
13 | E x p i n c r e a s e = 0 ; #1;
14 | E x p d e c r e a s e = 1 ; #2;
15 | E x p d e c r e a s e = 0 ; #2;
16 | I n i t = 1 ; #1;
17 | I n i t = 0 ; #5;

18
19 end

20
21 | always
22 | #0.5 Clk = ! Clk ;
23 | i n i t i a l
24 | #50 $ f i n i s h ;
25 | endmodule

## B Analog krets

B.1 | Firepikselskrets
1 | F ou rPi xel

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

5
6 X11 VDD 0 Expose E rase NRE R1 OUT1 OnePixel 7 X12 VDD 0 Expose E rase NRE R1 OUT2 OnePixel 8 X21 VDD 0 Expose E rase NRE R2 OUT1 OnePixel 9 X22 VDD 0 Expose E rase NRE R2 OUT2 OnePixel

10
11 . subck t OnePixel Vdd Vss Expose E rase NRE Out 12 XPD1 Vdd N1 PhotoDiode
13 MN1 N1 Expose N2 0 NMOS L=0.7u W=10u
14 MN2 N2 E rase 0 0 NMOS L=2u W=2u
15 CS N2 0 1. 3 p
16 MP3 0 N2 N3 Vdd PMOS L=0.7u W=10u 17 MP4 N3 NRE Out Vdd PMOS L=0.7u W=10u

18
19 MC Out Out Vdd Vdd PMOS L=2u W=2u 20 CC Out 0 3p
21 . ends

22
23 | . subck t PhotoDiode | VDD N1 R1C1
24 | I 1 R1C1 | VDD | N1 R1C1 | DC | Ipd 1
25 | d1 N1 R1C1 vdd dw ell 1
26 | . model d w ell d c j 0=1e−14 i s =1e−12 m=0.5 bv=40
27 | Cd1 N1 R1C1 VDD 30 f
28 | . ends

B.2 | Analog testbenk
1 | Testbench

2
3 | . param Ipd 1 = 50p ! Photodiode c u r r e n t , r an ge [ 5 0 pA, 750 pA]
4 | . param VDD = 1. 8 ! Supply v ol t a g e
5 | . param EXPOSURETIME = 30m ! Exposure time , r an ge [ 2 ms , 30 ms ]

6
7 . param TRF = {EXPOSURETIME/100} ! Ri se tim e and f a l l t i m e o f EXPOSURE and ERASE s i g n a l s
8 | . param PW = {EXPOSURETIME} ! Pul sewid th o f EXPOSURE and ERASE s i g n a l s
9 | . param PERIOD = {EXPOSURETIME∗10} ! Pe ri od f o r t e s t b e n c h s o u r c e s
10 | . param FS = 1k ; ! Sampling cl o c k f r e q u e n c y
11 | . param CLK PERIOD = {1/FS} ! Sampling cl o c k p e ri o d
12 | . param EXPOSE DLY = {CLK PERIOD} ! Delay f o r EXPOSE s i g n a l
13 | . param NRE R1 DLY = {2∗CLK PERIOD + EXPOSURETIME} ! Delay f o r NRE s i g n a l
14 | . param NRE R2 DLY = {4∗CLK PERIOD + EXPOSURETIME} ! Delay f o r NRE s i g n a l
15 | . param ERASE DLY = {6∗CLK PERIOD + EXPOSURETIME} ! Delay f o r ERASE s i g n a l

16
17 VDD Vdd 0 dc VDD
18 VEXPOSE Expose 0 dc 0 p ul s e ( 0 VDD EXPOSE DLY TRF TRF EXPOSURETIME PERIOD) 19 VERASE E rase 0 dc 0 p ul s e ( 0 VDD ERASE DLY TRF TRF CLK PERIOD PERIOD)
20 VNRE R1 NRE R1 0 dc 0 p ul s e (VDD 0 NRE R1 DLY TRF TRF CLK PERIOD PERIOD) 21 VNRE R2 NRE R2 0 dc 0 p ul s e (VDD 0 NRE R2 DLY TRF TRF CLK PERIOD PERIOD)

22
23 . pl o t V(EXPOSE) V(ERASE) V(Out 1 ) V(Out 2 ) V(NRE R1 ) V(NRE R2 )
