torsteml/TFE4152-Project/sketchFSM.pdf

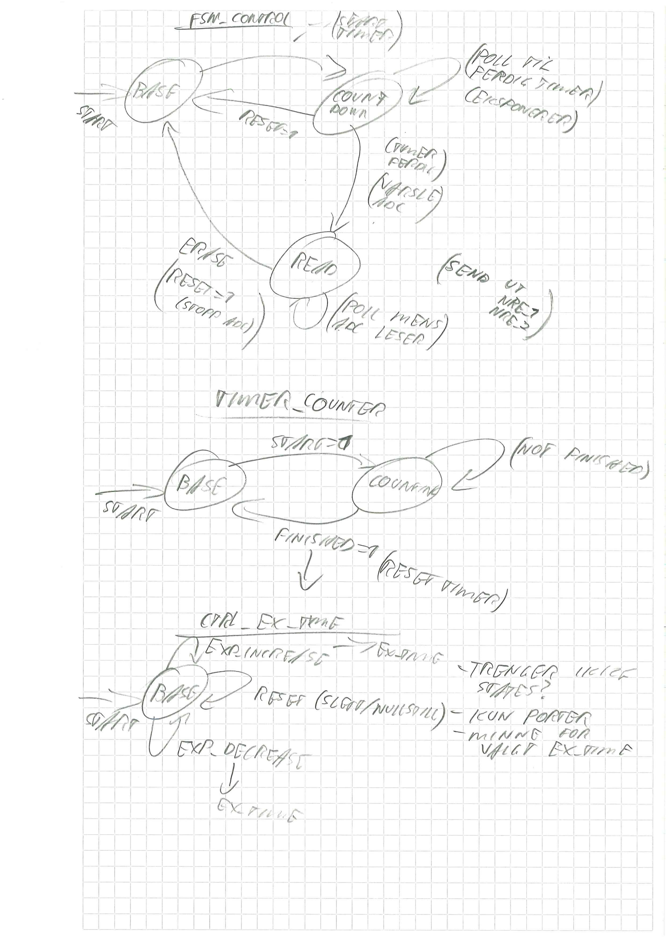
[picture p23: page 1]
