torsteml/TFE4152-Project/750 vs 2/Plot 3 av 4 transistorer på max.PNG

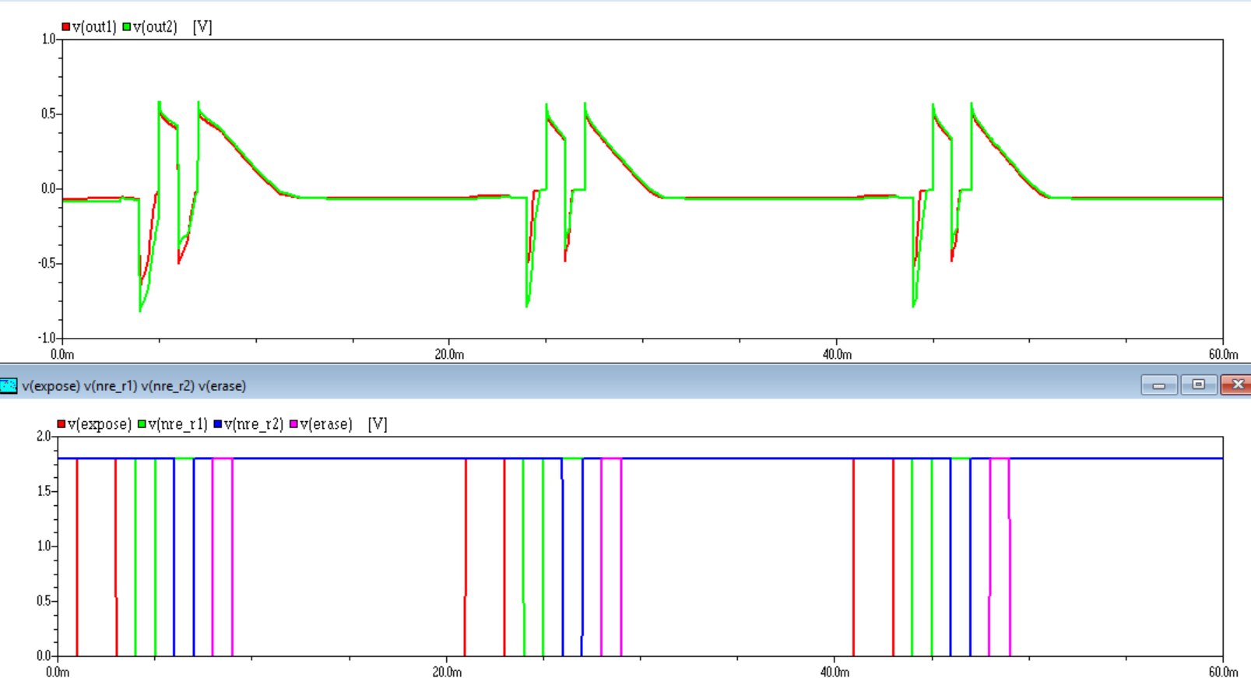
750 vs 2/Plot 3 av 4 transistorer på max.PNG
