torsteml/TFE4152-Project/750 vs 2/Plot alle transistorer på min.PNG

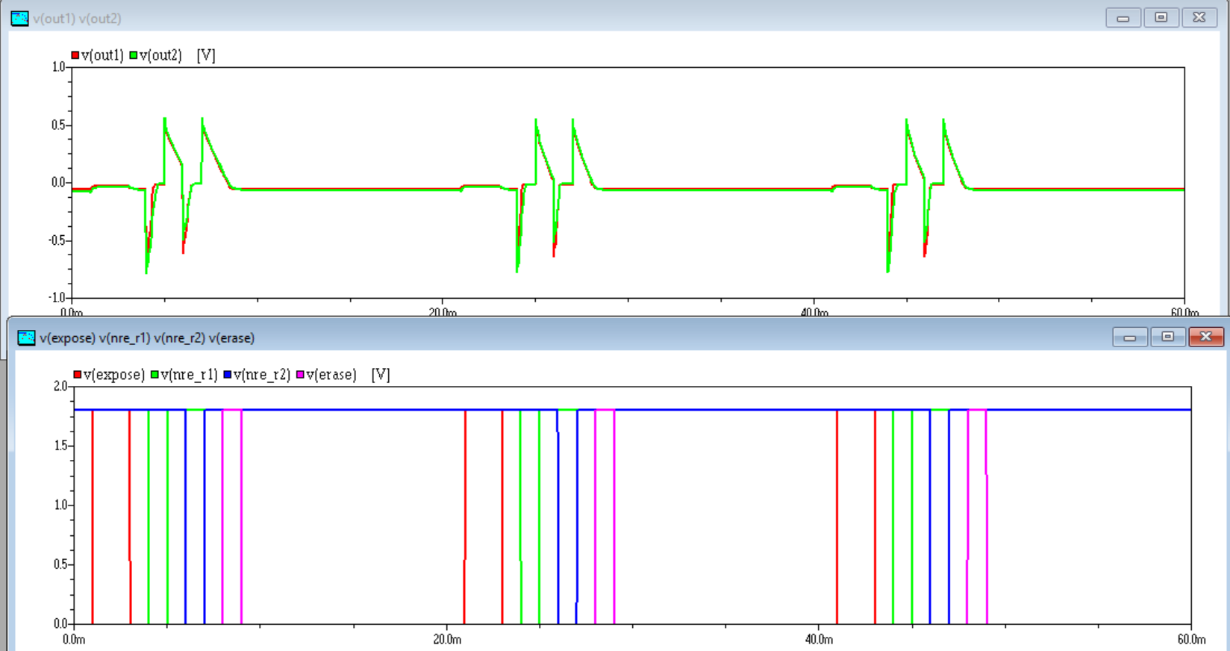
750 vs 2/Plot alle transistorer på min.PNG
