torsteml/TFE4152-Project/report/images/AnalogSim4pixels50v30.PNG

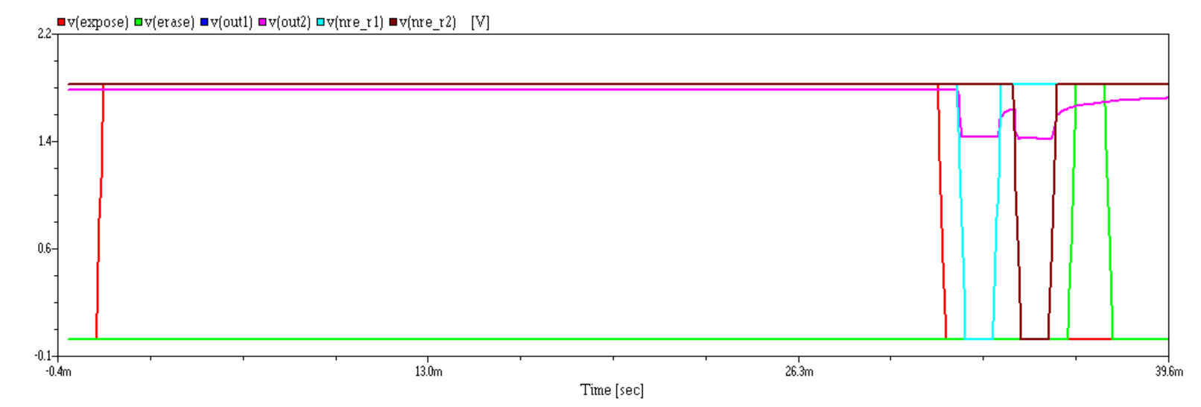
report/images/AnalogSim4pixels50v30.PNG
