torsteml/TFE4152-Project/report/images/AnalogSim4pixels750v2.PNG

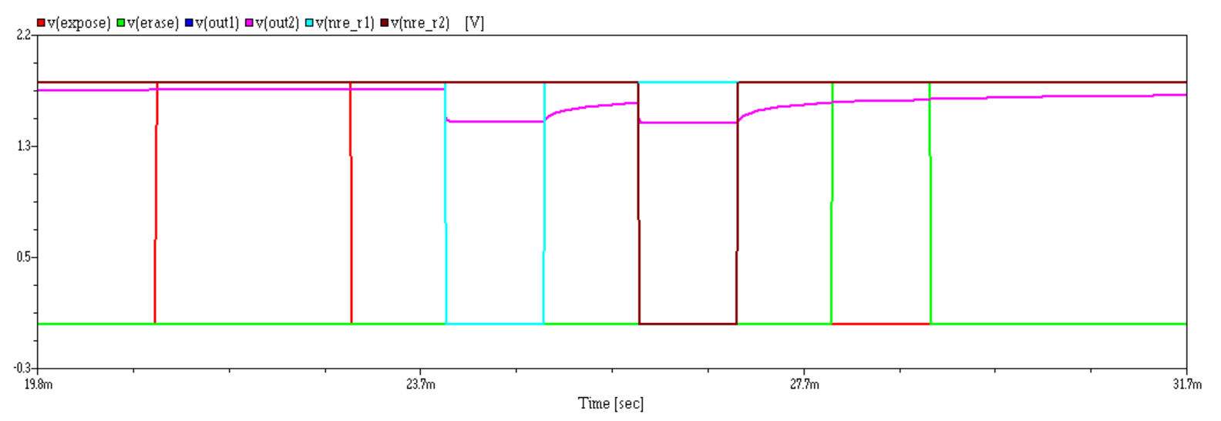
report/images/AnalogSim4pixels750v2.PNG
