torsteml/TFE4152-Project/report/images/AnalogSim50v30.PNG

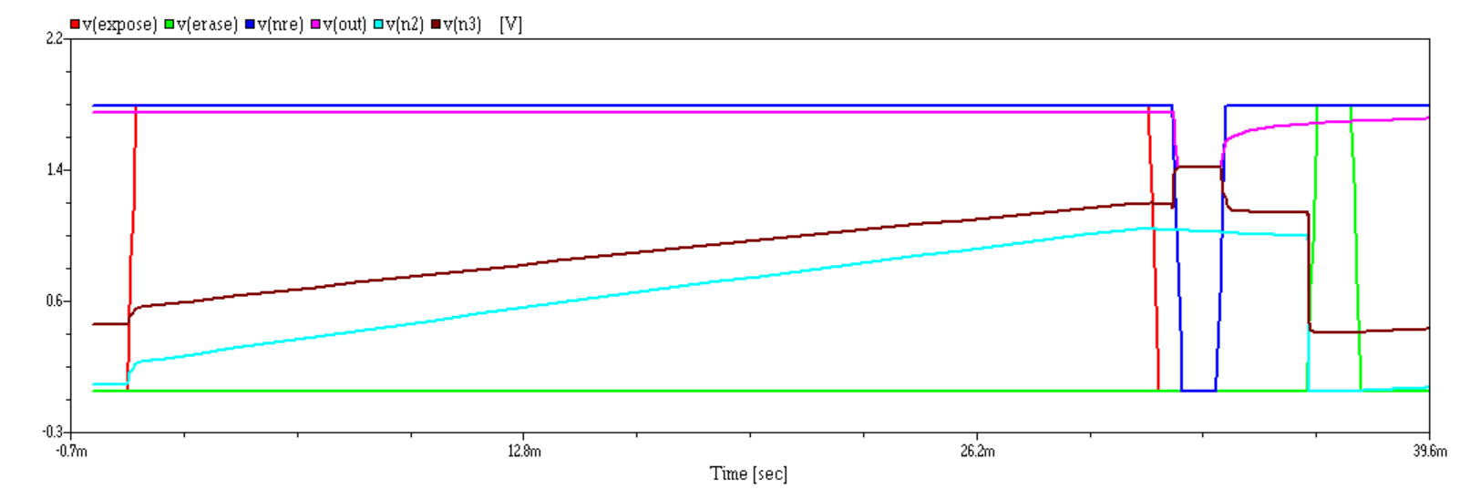
report/images/AnalogSim50v30.PNG
