torsteml/TFE4152-Project/report/images/AnalogSim50v30C0833.PNG

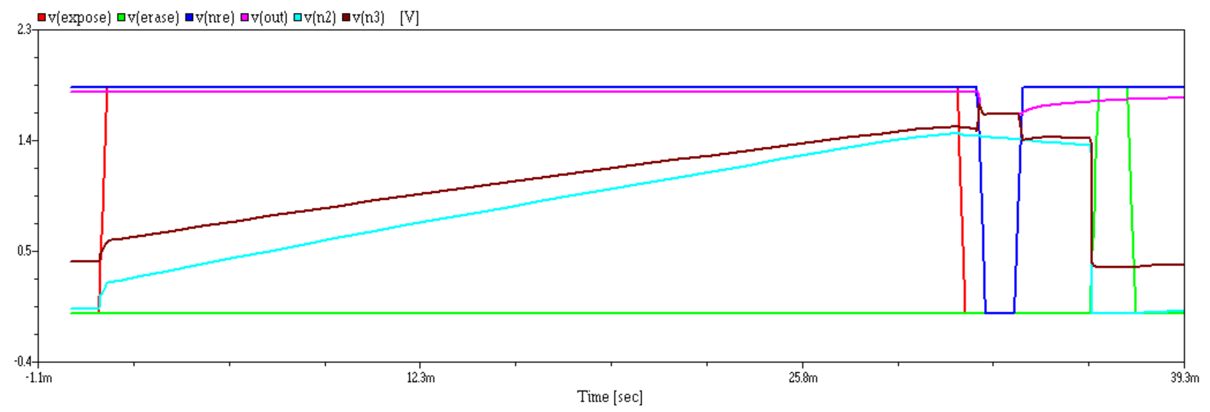
report/images/AnalogSim50v30C0833.PNG
