torsteml/TFE4152-Project/report/images/AnalogSim750v2.PNG

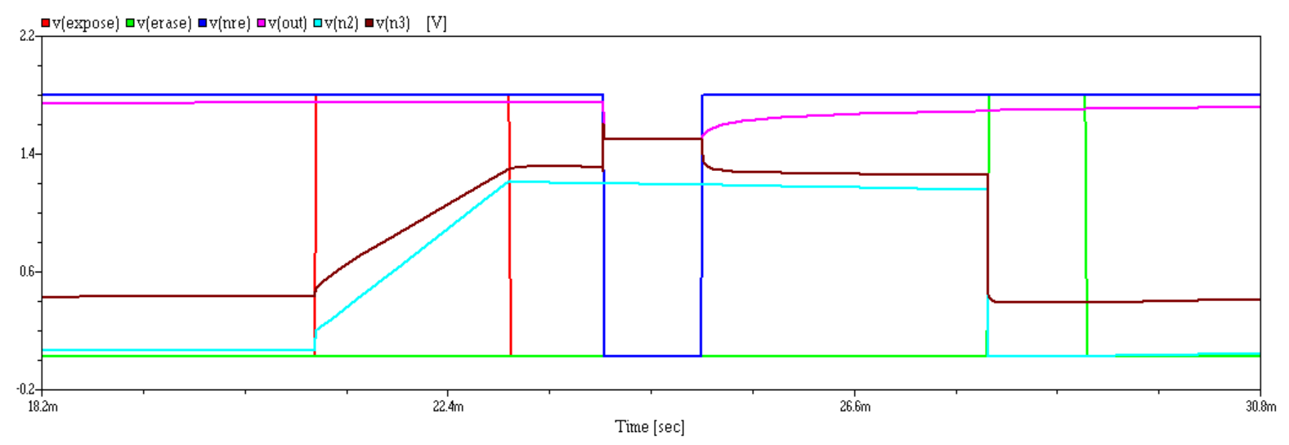
report/images/AnalogSim750v2.PNG
