torsteml/TFE4152-Project/report/images/AnalogSim750v2C0833.PNG

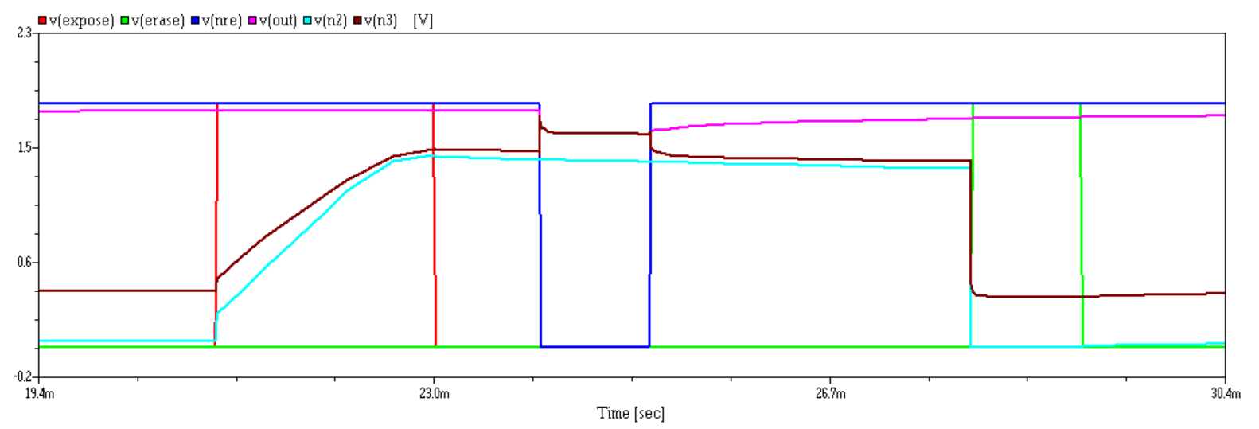
report/images/AnalogSim750v2C0833.PNG
