torsteml/TFE4152-Project/report/images/FSM.PNG

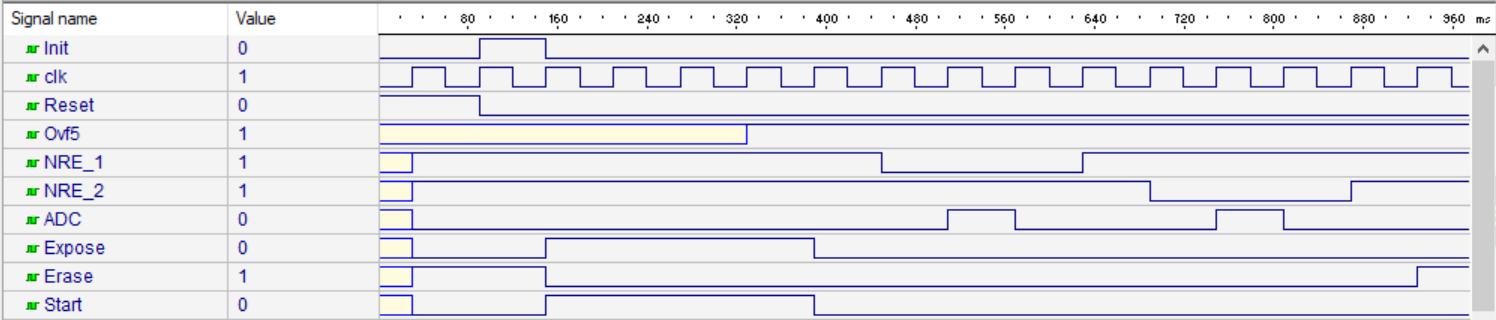
report/images/FSM.PNG
