torsteml/TFE4152-Project/report/images/FSM_ex_control_reset.PNG

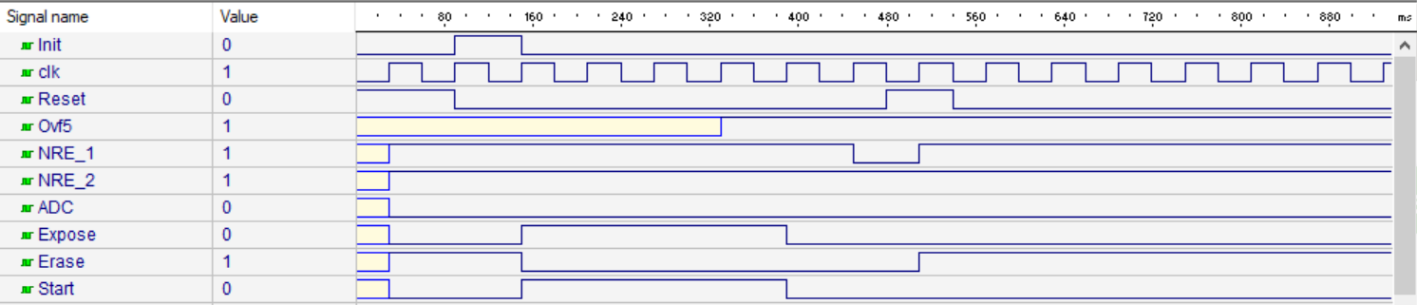
report/images/FSM_ex_control_reset.PNG
