torsteml/TFE4152-Project/report/images/NMOSandPMOS.png

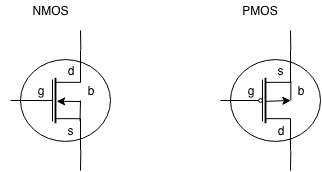
report/images/NMOSandPMOS.png
