torsteml/TFE4152-Project/report/images/ntnu_hele_navnet_staaende_bm.png

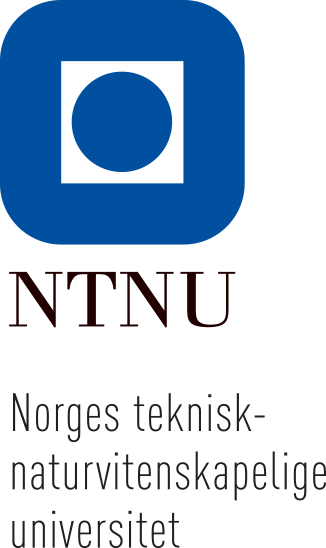
report/images/ntnu_hele_navnet_staaende_bm.png
