torsteml/TFE4152-Project/report/images/SimuleringHeleDigKrets.PNG

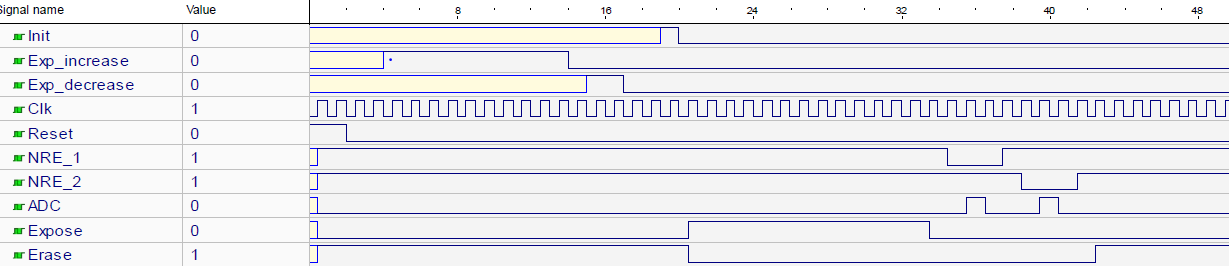
report/images/SimuleringHeleDigKrets.PNG
