torsteml/TFE4152-Project/report/images/SimuleringReset.PNG

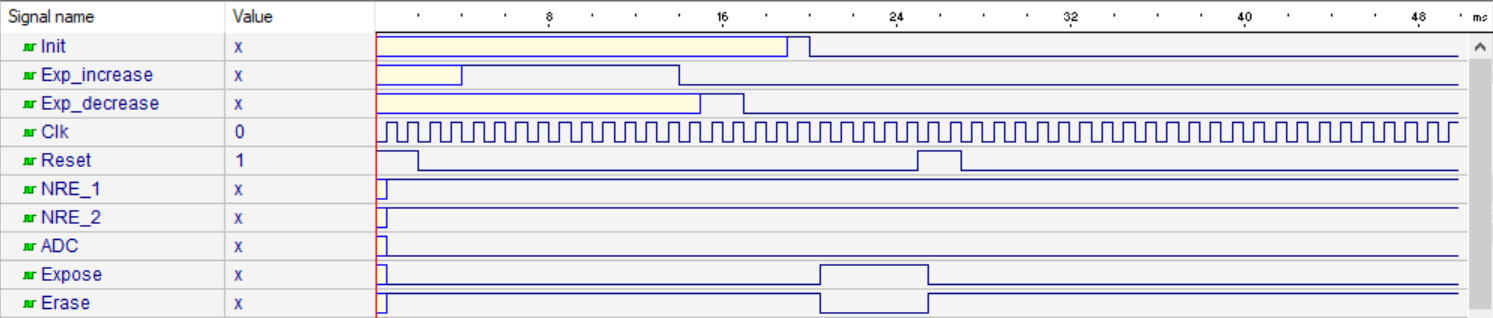
report/images/SimuleringReset.PNG
