torsteml/TFE4152-Project/report/images/TimercounterStates.png

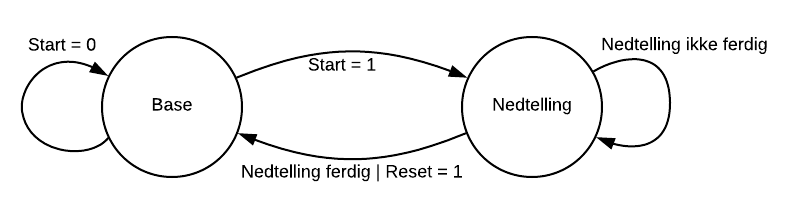
report/images/TimercounterStates.png
