torsteml/TFE4152-Project/report/images/timingDiagramDigital.png

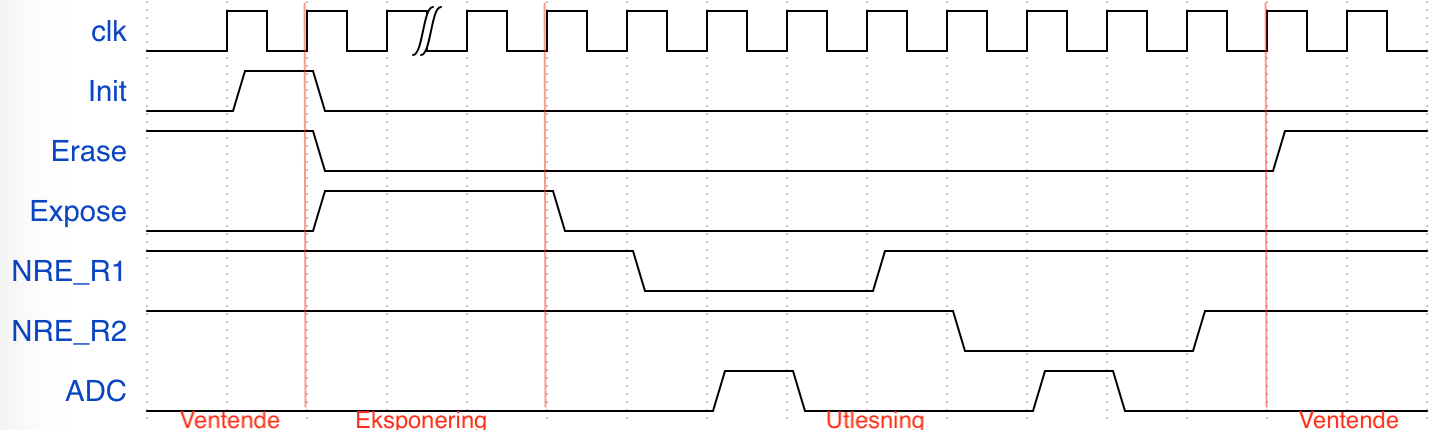
report/images/timingDiagramDigital.png
