torsteml/TFE4152-Project/report/matlab/plots/plot50v30Decay4.png

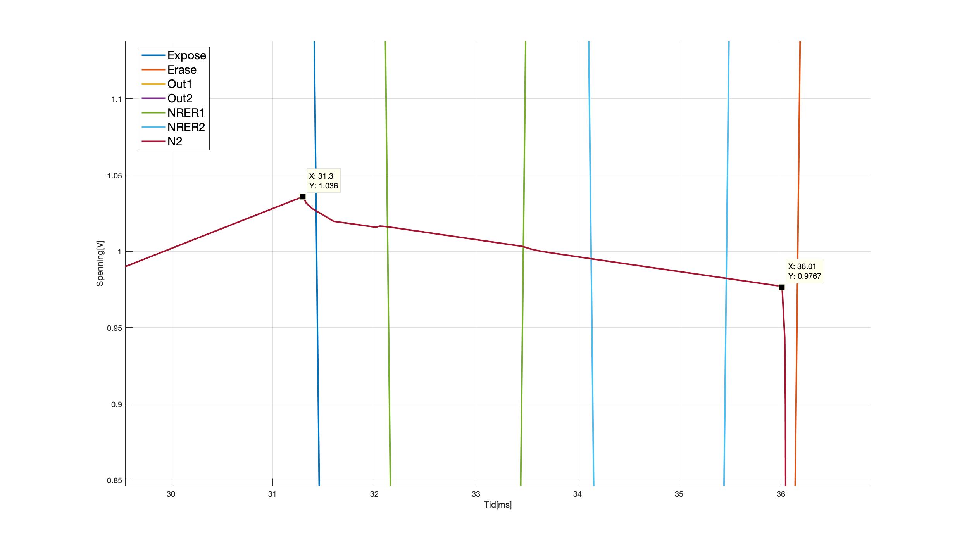
report/matlab/plots/plot50v30Decay4.png
