torsteml/TFE4152-Project/report/matlab/plots/plot750v2Decay4.png

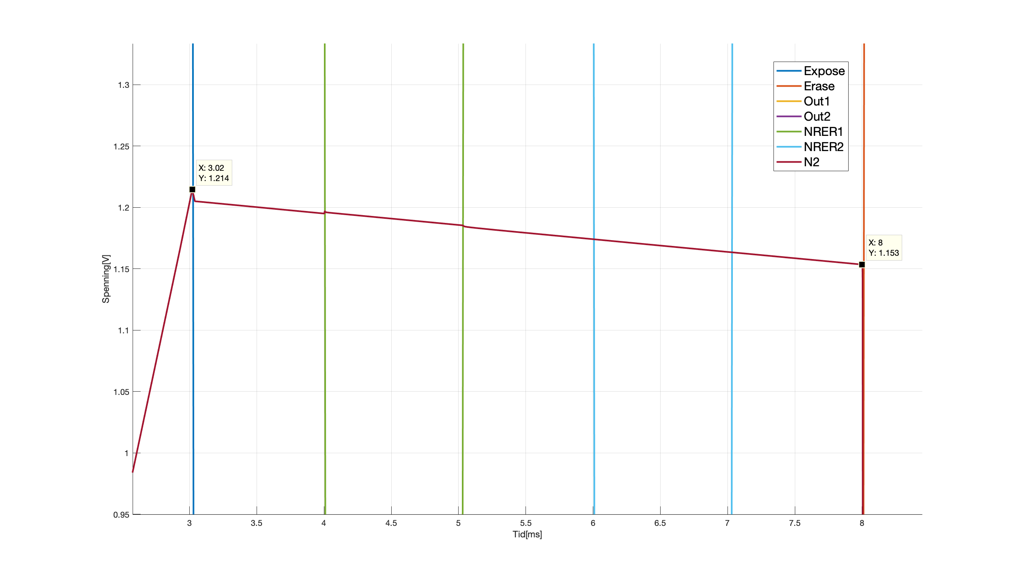
report/matlab/plots/plot750v2Decay4.png
