torsteml/TFE4152-Project/report/matlab/plots/plot750v21pixel.png

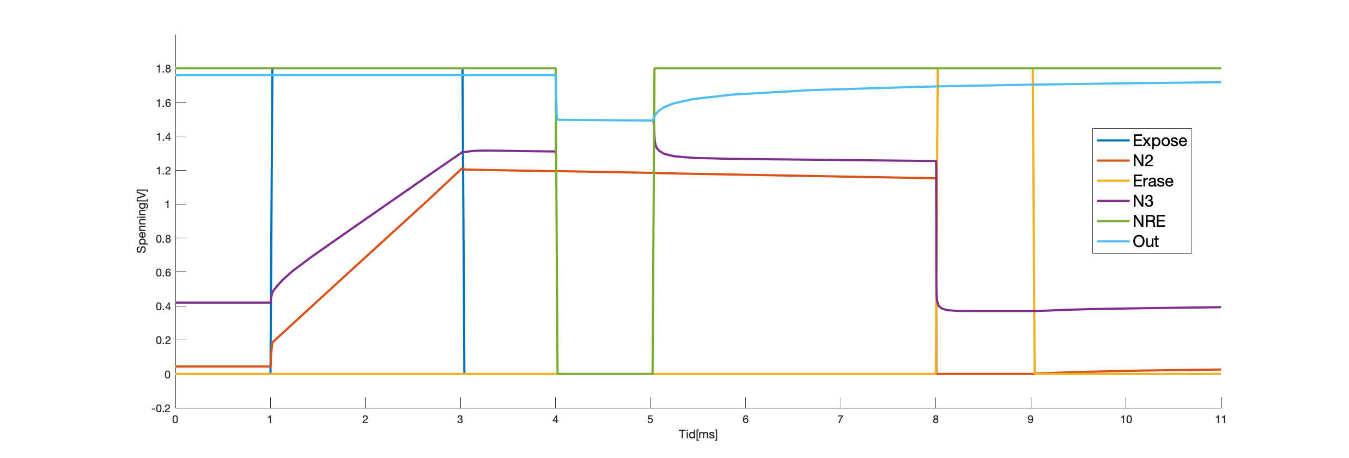
report/matlab/plots/plot750v21pixel.png
