torsteml/TFE4152-Project/report/matlab/Result50v301pixel.csv

4:OnePixel
Transient Analysis
Tue Nov 20 15:09:36 2018
Input file: \\tsclient\C\Users\marku\Documents\ICdrit\OnePixel.cir
time [sec] | v(vdd) [V] | v(n1) [V] | v(expose) [V] | v(n2) [V] | v(erase) [V] | v(n3) [V] | v(nre) [V] | v(out) [V] | v(mc.drain) [V] | v(mc.source) [V] | v(mp4.drain) [V] | v(mp4.source) [V] | v(mp3.drain) [V] | v(mp3.source) [V] | v(mn2.drain) [V] | v(mn2.source) [V] | v(mn1.drain) [V] | v(mn1.source) [V] | i(vnre) [A] | i(verase) [A] | i(vexpose) [A] | i(vdd) [A]
0 | 1.8 | 1.89513 | 0 | 0.0425065 | 0 | 0.419475 | 1.8 | 1.75935 | 1.75935 | 1.8 | 0.419475 | 1.75935 | 1.12779e-10 | 0.419475 | 0.0425065 | 3.6827e-11 | 1.89513 | 0.0425065 | 0 | 0 | 0 | -2.81744e-11
1e-06 | 1.8 | 1.89516 | 0 | 0.0425029 | 0 | 0.419396 | 1.8 | 1.75935 | 1.75935 | 1.8 | 0.419396 | 1.75935 | 1.25121e-10 | 0.419396 | 0.0425029 | 3.68262e-11 | 1.89516 | 0.0425029 | 6.80047e-13 | -2.91599e-14 | -6.87075e-13 | -2.46627e-11
2e-06 | 1.8 | 1.89517 | 0 | 0.0424994 | 0 | 0.419395 | 1.8 | 1.75935 | 1.75935 | 1.8 | 0.419395 | 1.75935 | 1.2494e-10 | 0.419395 | 0.0424994 | 3.68254e-11 | 1.89517 | 0.0424994 | 6.69713e-13 | -3.39287e-14 | -6.23814e-13 | -2.48241e-11
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
