torsteml/TFE4152-Project/report/matlab/Result750v21pixel.csv

5:OnePixel
Transient Analysis
Tue Nov 20 15:10:03 2018
Input file: \\tsclient\C\Users\marku\Documents\ICdrit\OnePixel.cir
time [sec] | v(vdd) [V] | v(n1) [V] | v(expose) [V] | v(n2) [V] | v(erase) [V] | v(n3) [V] | v(nre) [V] | v(out) [V] | v(mc.drain) [V] | v(mc.source) [V] | v(mp4.drain) [V] | v(mp4.source) [V] | v(mp3.drain) [V] | v(mp3.source) [V] | v(mn2.drain) [V] | v(mn2.source) [V] | v(mn1.drain) [V] | v(mn1.source) [V] | i(vnre) [A] | i(verase) [A] | i(vexpose) [A] | i(vdd) [A]
0 | 1.8 | 1.97085 | 0 | 0.0433061 | 0 | 0.42011 | 1.8 | 1.75936 | 1.75936 | 1.8 | 0.42011 | 1.75936 | 1.12755e-10 | 0.42011 | 0.0433061 | 3.69974e-11 | 1.97085 | 0.0433061 | 0 | 0 | 0 | -2.84281e-11
1e-06 | 1.8 | 1.97085 | 0 | 0.0433012 | 0 | 0.420001 | 1.8 | 1.75936 | 1.75936 | 1.8 | 0.420001 | 1.75936 | 1.29256e-10 | 0.420001 | 0.0433012 | 3.69963e-11 | 1.97085 | 0.0433012 | 9.10478e-13 | -6.45168e-15 | -3.30694e-14 | -2.49902e-11
2e-06 | 1.8 | 1.97085 | 0 | 0.0432965 | 0 | 0.419999 | 1.8 | 1.75936 | 1.75936 | 1.8 | 0.419999 | 1.75936 | 1.29011e-10 | 0.419999 | 0.0432965 | 3.69954e-11 | 1.97085 | 0.0432965 | 8.966e-13 | -1.2894e-14 | -6.6354e-14 | -2.50416e-11
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
