torsteml/TFE4152-Project/report/matlab/Result750v24pixel.csv

2:FourPixel
Transient Analysis
Tue Nov 20 15:07:46 2018
Input file: \\tsclient\C\Users\marku\Documents\ICdrit\FourPixel.cir
time [sec] | v(vdd) [V] | v(11:n1) [V] | v(expose) [V] | v(11:n2) [V] | v(erase) [V] | v(11:n3) [V] | v(nre_r1) [V] | v(out1) [V] | v(12:n1) [V] | v(12:n2) [V] | v(12:n3) [V] | v(out2) [V] | v(21:n1) [V] | v(21:n2) [V] | v(21:n3) [V] | v(nre_r2) [V] | v(22:n1) [V] | v(22:n2) [V] | v(22:n3) [V] | v(m:22:c.drain) [V] | v(m:22:c.source) [V] | v(m:22:p4.drain) [V] | v(m:22:p4.source) [V] | v(m:22:p3.drain) [V] | v(m:22:p3.source) [V] | v(m:21:c.drain) [V] | v(m:21:c.source) [V] | v(m:21:p4.drain) [V] | v(m:21:p4.source) [V] | v(m:21:p3.drain) [V] | v(m:21:p3.source) [V] | v(m:12:c.drain) [V] | v(m:12:c.source) [V] | v(m:12:p4.drain) [V] | v(m:12:p4.source) [V] | v(m:12:p3.drain) [V] | v(m:12:p3.source) [V] | v(m:11:c.drain) [V] | v(m:11:c.source) [V] | v(m:11:p4.drain) [V] | v(m:11:p4.source) [V] | v(m:11:p3.drain) [V] | v(m:11:p3.source) [V] | v(m:22:n2.drain) [V] | v(m:22:n2.source) [V] | v(m:22:n1.drain) [V] | v(m:22:n1.source) [V] | v(m:21:n2.drain) [V] | v(m:21:n2.source) [V] | v(m:21:n1.drain) [V] | v(m:21:n1.source) [V] | v(m:12:n2.drain) [V] |
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
