torsteml/TFE4152-Project/Digital del/camera/compile.cfg

[View]
Entity=RE_control_TB
Architecture=
TopLevelType=3
[file:.\src\CTRL_ex_time.v]
Enabled=1
LIB=Active library
Strict=0
VerilogLanguage=8
VerilogNoSpecify=0
DisabledAssertionsProcessing=None
DisableEmbeddedOvaPslProcessing=0
DisableOvaProcessing=0
DisablePslProcessing=0
DisableSvaProcessing=0
[file:.\src\Timer_counter.v]
Enabled=1
[file:.\src\FSM_ex_control.v]
Enabled=1
[file:.\src\CTRL_ex_time_TB.v]
Enabled=1
[file:.\src\FSM_ex_control_TB.v]
Enabled=1
[file:.\src\Timer_counter_TB.v]
Enabled=1
[file:.\src\RE_control.v]
Enabled=1
[file:.\src\RE_control_TB.v]
Enabled=1
[file:.\src\CounterStuff.v]
Enabled=1
[file:.\src\counterStuff_TB.v]
Enabled=1
