torsteml/TFE4152-Project/(commit log)

2018-10-19 la til notayetr
2018-10-23 Delte opp kretsen i mindre deler + la til info
2018-11-06 div lagt inn
    [Sannhetstabell.xlsx]
2018-11-07 la inn verilog
    [compile.cfg, library.cfg, projlib.cfg]
2018-11-10 nesten fullfort verilog
    [compile.cfg, library.cfg, projlib.cfg]
2018-11-12 la inn diverse
2018-11-15 la inn div plot
2018-11-16 added schematics
2018-11-16 la til div
2018-11-19 la inn flere simuleringer
2018-11-20 la inn csv filer
    [Result50v301pixel.csv, Result50v304pixel.csv, Result750v21pixel.csv, Result750v24pixel.csv]
